Artemis-98/goldon/docs/schematic.html

# شماتیک دقیق اتصالات — برد حیاط

ESP32-S3-N8R2 · SIM800L EVB · ULN2003AN · ۲× رله · ۲× پمپ ۳V · سنسورها

منبع حقیقت: جدول اتصالات پروژه — نه خروجی حدسی AI · نسخه ۱.۰

## فهرست شیت‌ها

۰) نت‌لیست کامل (مرجع اصلی) ۱) شماتیک تغذیه ۲) شماتیک SIM800L + UART ۳) اتصالات کامل سنسورها ۴) اتصالات کامل ULN2003 + رله + پمپ ۵) نقشه GPIO استفاده شده

## ۰) نت‌لیست کامل — مرجع اصلی

هر ردیف = یک شبکه الکتریکی مشترک. هر چیزی که روی یک نت است به هم وصل است.

### باس‌های تغذیه

نام نت | اعضا (همه به هم وصل) | توضیح
+5V_BANK | خروجی + پاوربانک · ESP32 پین 5V (ورودی USB/برق برد) · SIM800L 5VIN · خازن ۱۰۰۰µF + · ULN2003 ۹ COM · رله۱ VCC · رله۲ VCC | ۵V تغذیه کنترل و کویل رله و SIM
GND | − پاوربانک · همه GNDهای ESP32 · SIM800L هر دو GND · خازن − · ULN ۸ · رله۱ GND · رله۲ GND · همه سنسورها GND · VDD منطق SIM به همین زمین برمی‌گردد | GND زمین مشترک کنترل
+3V3 | ESP32 3V3 · SIM800L VDD · خاک۱ VCC · خاک۲ VCC · DHT11 VCC · AP3216 VCC · سطح‌آب + | ۳٫۳V فقط منطق/سنسور — نه کویل رله
+3V_PUMP | خروجی + منبع ۳V جدا · COM رله۱ · COM رله۲ | ۳V فقط سمت پمپ
GND_PUMP | − منبع ۳V · − پمپ۱ · − پمپ۲ | ۳V GND می‌تواند از GND کنترل جدا بماند

### سیگنال‌ها

نام نت | از | به | جهت
SIM_TX | SIM800L TXD | ESP32 GPIO16 (RX UART1) | SIM → ESP
SIM_RX | ESP32 GPIO17 (TX UART1) | SIM800L RXD | ESP → SIM
SIM_RST | ESP32 GPIO18 | SIM800L RST | ESP → SIM
SOIL1_AO | خاک۱ AO | ESP32 GPIO1 | آنالوگ
SOIL2_AO | خاک۲ AO | ESP32 GPIO2 | آنالوگ
DHT_DATA | DHT11 DATA | ESP32 GPIO4 | ۱-سیم
I2C_SDA | AP3216 SDA | ESP32 GPIO5 | I2C
I2C_SCL | AP3216 SCL | ESP32 GPIO9 | I2C
WATER_S | سطح‌آب S | ESP32 GPIO7 | دیجیتال
RLY1_IN_B | ESP32 GPIO10 | ULN2003 ۱ (1B) | ESP → ULN
RLY2_IN_B | ESP32 GPIO11 | ULN2003 ۲ (2B) | ESP → ULN
RLY1_IN | ULN2003 ۱۶ (1C) | رله۱ IN | ULN → رله (open-collector / sink)
RLY2_IN | ULN2003 ۱۵ (2C) | رله۲ IN | ULN → رله
PUMP1+ | رله۱ NO | پمپ۱ + | سوییچ‌شده از +3V_PUMP
PUMP2+ | رله۲ NO | پمپ۲ + | سوییچ‌شده از +3V_PUMP

قواعد قطعی:

- UART متقاطع است: TXD سیم به RX برد، RXD سیم به TX برد.
- IN رله هرگز مستقیم به GPIO وصل نمی‌شود؛ فقط از خروجی C روی ULN.
- خازن ۱۰۰۰µF موازی روی نت‌های +5V_BANK و GND نزدیک SIM است، نه سری.
- پین‌های استفاده‌نشده ULN (۳–۷ و ۱۰–۱۴) باز می‌مانند.

## ۱) شماتیک تغذیه

## ۲) شماتیک SIM800L + UART

## ۳) اتصالات کامل سنسورها

همه سنسورها از ۳٫۳V ESP تغذیه می‌شوند — نه از ۵V. GND همه مشترک با ESP است.

۳٫۳V مشترک

ESP 3V3 → VCC همه سنسورها · VDD سیم‌کارت منطق SIM جداست ولی همین ۳٫۳V

GND مشترک

ESP GND → GND همه سنسورها

### ۱) رطوبت خاک ۱ — HW-103 (گیاه ۱)

پین سنسور | وصل به | رنگ | توضیح
VCC | ESP 3.3V | آبی روشن | نه ۵V
GND | ESP GND | مشکی
AO | ESP GPIO 1 | نارنجی | مقدار آنالوگ
DO | — | — | وصل نکن

### ۲) رطوبت خاک ۲ — HW-103 (گیاه ۲)

پین سنسور | وصل به | رنگ | توضیح
VCC | ESP 3.3V | آبی روشن | نه ۵V
GND | ESP GND | مشکی
AO | ESP GPIO 2 | نارنجی | مقدار آنالوگ
DO | — | — | وصل نکن

### ۳) دما / رطوبت هوا — DHT11

پین سنسور | وصل به | رنگ | توضیح
VCC (+) | ESP 3.3V | آبی روشن | نه ۵V
GND (−) | ESP GND | مشکی
DATA (وسط / S) | ESP GPIO 4 | نارنجی | سیگنال ۱-سیم

### ۴) نور محیط — AP3216 (I2C)

پین سنسور | وصل به | رنگ | توضیح
VCC | ESP 3.3V | آبی روشن | نه ۵V
GND | ESP GND | مشکی
SDA | ESP GPIO 5 | آبی | I2C Data
SCL | ESP GPIO 9 | بنفش | I2C Clock

### ۵) سنسور سطح آب (۳ پین)

پین سنسور | وصل به | رنگ | توضیح
+ (VCC) | ESP 3.3V | آبی روشن | نه ۵V
− (GND) | ESP GND | مشکی
S (Signal) | ESP GPIO 7 | نارنجی | معمولاً HIGH = آب هست

### جدول خلاصه GPIO سنسورها

GPIO | سنسور | پین ماژول | نوع
1 | خاک ۱ | AO | آنالوگ
2 | خاک ۲ | AO | آنالوگ
4 | DHT11 | DATA | دیجیتال
5 | AP3216 | SDA | I2C
9 | AP3216 | SCL | I2C
7 | سطح آب | S | دیجیتال
3V3 | همه | VCC / + | تغذیه
GND | همه | GND / − | زمین

ترتیب وصل پیشنهادی:

- اول ۳٫۳V و GND مشترک را برای همه سنسورها بکش.
- بعد سیگنال‌ها: خاک۱→GPIO1 ، خاک۲→GPIO2 ، DHT→GPIO4 ، سطح آب→GPIO7.
- در آخر AP3216: SDA→GPIO5 ، SCL→GPIO9.
- پروب خاک (میله‌ها) را در خاک بگذار؛ ماژول الکترونیک بیرون بماند.
- وقتی وصل شد بگو تا فریمور تست سنسورها را روی برد بریزم.

## ۴) اتصالات کامل ULN2003 + رله + پمپ

رله را مستقیم به GPIO نزن. مسیر درست: ESP32 → ULN2003 → IN رله → پمپ ۳V. دیود flyback جدا لازم نیست؛ با وصل پین ۹ ULN به ۵V، دیودهای داخلی فعال می‌شوند.

### دو منبع برق

منبع ۵ ولت (پاوربانک)

+ ← VCC هر دو رله · پین ۹ ULN
− ← GND مشترک با ESP و ULN و رله

منبع ۳ ولت (جدا)

+ ← فقط COM هر دو رله
− ← فقط − هر دو پمپ · مستقیم به ESP وصل نشود

### ۱) ULN2003AN

ناچ (فرورفتگی) بالا باشد. پین ۱ سمت چپ بالاست.

پین ULN | نام | وصل به | رنگ
۱ | 1B | ESP32 GPIO 10 | نارنجی
۲ | 2B | ESP32 GPIO 11 | نارنجی
۸ | GND | GND مشترک | مشکی
۹ | COM | ۵V پاوربانک | قرمز · الزامی
۱۶ | 1C | IN رله ۱ | نارنجی
۱۵ | 2C | IN رله ۲ | نارنجی

پین‌های ۳ تا ۷ و ۱۰ تا ۱۴ را وصل نکن (باز بمانند).

### ۲) رله ۱ (پمپ گیاه ۱)

پین رله | وصل به | توضیح
VCC | ۵V پاوربانک | کویل رله
GND | GND مشترک | زمین کنترل
IN | ULN پین ۱۶ (1C) | نه مستقیم از ESP
COM (ترمینال بزرگ) | + منبع ۳V | ورودی برق پمپ
NO (ترمینال بزرگ) | + پمپ ۱ | خروجی وقتی رله روشن است

### ۳) رله ۲ (پمپ گیاه ۲)

پین رله | وصل به | توضیح
VCC | ۵V پاوربانک | کویل رله
GND | GND مشترک | زمین کنترل
IN | ULN پین ۱۵ (2C) | نه مستقیم از ESP
COM | + منبع ۳V | ورودی برق پمپ
NO | + پمپ ۲ | خروجی وقتی رله روشن است

### ۴) پمپ‌ها

پمپ | پایه + | پایه −
پمپ ۱ | NO رله ۱ | − منبع ۳V
پمپ ۲ | NO رله ۲ | − منبع ۳V

### مسیر سیگنال

GPIO10 → ULN 1B → ULN 1C → IN رله۱ → (COM/NO) → پمپ۱
GPIO11 → ULN 2B → ULN 2C → IN رله۲ → (COM/NO) → پمپ۲

منطق: digitalWrite(10, HIGH) = پمپ ۱ روشن · LOW = خاموش · GPIO 11 برای پمپ ۲.

### جدول خلاصه همه اتصالات این بخش

از | به | رنگ | توضیح
GPIO 10 | ULN پین ۱ (1B) | نارنجی | سیگنال رله ۱
GPIO 11 | ULN پین ۲ (2B) | نارنجی | سیگنال رله ۲
ULN پین ۸ | GND مشترک | مشکی | زمین کنترل
ULN پین ۹ | ۵V پاوربانک | قرمز | دیودهای داخلی ULN
ULN پین ۱۶ | IN رله ۱ | نارنجی | خروجی کانال ۱
ULN پین ۱۵ | IN رله ۲ | نارنجی | خروجی کانال ۲
VCC هر رله | ۵V پاوربانک | قرمز | کویل رله
GND هر رله | GND مشترک | مشکی | زمین کنترل
+ منبع ۳V | COM هر رله | قرمز | برق پمپ
NO هر رله | + پمپ مربوط | سبز | سوییچ پمپ
− پمپ | − منبع ۳V | مشکی | برگشت پمپ

ترتیب وصل پیشنهادی:

- اول ULN به ESP (GPIO10/11 + GND + پین ۹ به ۵V).
- بعد دو رله: VCC و GND و IN از ULN.
- اول بدون پمپ تست کن (فقط صدای کلیک رله).
- در آخر منبع ۳V و پمپ‌ها را وصل کن.
- GND کنترل (ESP و ULN و رله) مشترک باشد؛ مسیر ۳V پمپ می‌تواند جدا بماند.

## ۵) نقشه GPIO استفاده شده (ESP32-S3)

GPIO | نت | ماژول | نوع
1 | SOIL1_AO | خاک ۱ AO | ADC ورودی
2 | SOIL2_AO | خاک ۲ AO | ADC ورودی
4 | DHT_DATA | DHT11 | دیجیتال ۱-سیم
5 | I2C_SDA | AP3216 | I2C
9 | I2C_SCL | AP3216 | I2C
10 | RLY1_IN_B | ULN 1B | خروجی
11 | RLY2_IN_B | ULN 2B | خروجی
7 | WATER_S | سطح آب | ورودی
16 | SIM_TX | SIM TXD | UART RX
17 | SIM_RX | SIM RXD | UART TX
18 | SIM_RST | SIM RST | خروجی

این شماتیک از روی جدول اتصالات تأییدشدهٔ پروژه نوشته شده. برای ساخت PCB در KiCad/Flux، همین نت‌لیست بخش ۰ را وارد کن — نه شماتیک حدسی AI.

گلدون هوشمند · schematic v1.0 · docs/schematic.html
