Artemis-98/goldon/docs/project-report/گزارش-پروژه-گلدون-هوشمند.docx

بسمه تعالی

[نام دانشگاه]

[نام دانشکده]

[نام گروه آموزشی]

گزارش پروژه کارشناسی

سیستم آبیاری و پایش هوشمند گلدون (IoT)

طراحی و پیاده‌سازی سیستم پایش و آبیاری هوشمند گلدون مبتنی بر ESP32 و ارتباط بی‌سیم

Design and Implementation of a Smart Planter Monitoring and Irrigation System Based on ESP32 and Wireless Communication

دانشجو: محمد تدین

شماره دانشجویی: [..........]

استاد راهنما: [........................]

سال تحصیلی [........]

صفحه عنوان

[نام دانشگاه] — [نام دانشکده] — [نام گروه]

عنوان پروژه

طراحی و پیاده‌سازی سیستم پایش و آبیاری هوشمند گلدون مبتنی بر ESP32 و ارتباط بی‌سیم

عنوان کوتاه

سیستم آبیاری و پایش هوشمند گلدون (IoT)

English Title

Design and Implementation of a Smart Planter Monitoring and Irrigation System Based on ESP32 and Wireless Communication

نام دانشجو: محمد تدین

شماره دانشجویی: [..........]

استاد راهنما: [نام استاد راهنما]

مقطع: کارشناسی

رشته / گرایش: [نام رشته]

# تقدیم

این گزارش را به خانوادهٔ گرامی‌ام که در طول تحصیل همواره پشتیبان من بودند، و به تمام کسانی که با صبر و تشویق، انگیزهٔ یادگیری عملی مهندسی را در من زنده نگه داشتند، تقدیم می‌کنم.

# سپاس‌گزاری

از استاد راهنمای محترم که با راهنمایی‌های ارزشمند خود مسیر انجام این پروژه را روشن ساختند، صمیمانه سپاسگزارم. همچنین از دوستان و هم‌کلاسی‌هایی که در مراحل آزمون سخت‌افزار و بازبینی نرم‌افزار یاری رساندند قدردانی می‌کنم. هرگونه کاستی در این گزارش بر عهدهٔ نگارنده است.

# چکیده

کمبود آب و نیاز به مراقبت منظم از گیاهان آپارتمانی و فضای کوچک حیاط، انگیزهٔ اصلی طراحی یک سامانهٔ محلی پایش و آبیاری هوشمند است. در این پروژه، یک معماری چندبرد مبتنی بر خانوادهٔ میکروکنترلر ESP32 پیاده‌سازی شده است که سه نقش اصلی را از هم جدا می‌کند: برد حیاط (Yard) مسئول حسگری و فرمان رلهٔ پمپ‌هاست؛ برد مودم (Modem Bridge) پل ارتباطی UART به شبکهٔ محلی بی‌سیم را فراهم می‌کند؛ و برد پنل لمسی (Panel) واسط کاربری محلی را روی نمایشگر TFT ارائه می‌دهد. یک برد اختیاری ESP32-C6 نیز برای نمایش آغازین (Splash) در نظر گرفته شده است. مغز تصمیم‌گیری روی رایانهٔ میزبان با زبان پایتون اجرا می‌شود و سیاست‌های ایمنی مانند آبیاری پالسی، قفل متقابل دو پمپ، و مدیریت خطا را اعمال می‌کند. ارتباط پنل با مودم از طریق درخواست‌های HTTP روی شبکهٔ محلی Wi-Fi انجام می‌شود و آدرس‌های IP در پیکربندی قابل تنظیم هستند. نتایج کیفی آزمون‌های منطقی نشان می‌دهد معماری تفکیک‌شده، اشکال‌زدایی و توسعهٔ تدریجی را آسان‌تر می‌کند و لایهٔ ایمنی میزبان از فرمان‌های خطرناک آبیاری جلوگیری می‌نماید. این گزارش جزئیات طراحی، پیاده‌سازی میان‌افزارها و موتور میزبان، و سناریوهای ارزیابی را بدون افشای اطلاعات حساس شبکه مستند می‌کند.

کلیدواژه‌ها: اینترنت اشیاء؛ ESP32؛ آبیاری هوشمند؛ پایش رطوبت خاک؛ ارتباط بی‌سیم؛ ایمنی سامانه‌ای

# Abstract

Water scarcity and the need for regular care of indoor and small-yard plants motivate a local smart monitoring and irrigation system. This undergraduate project implements a multi-board architecture based on the ESP32 family that separates three roles: the Yard board handles sensing and pump-relay actuation; the Modem Bridge board provides a UART-to-local-Wi-Fi bridge; and the Panel board offers a local touch UI on an ILI9341 TFT. An optional ESP32-C6 splash board is supported. Decision-making runs on a laptop host written in Python, enforcing safety policies such as pulse irrigation, a dual-pump mutual exclusion lock, and fault handling. The panel communicates with the modem over HTTP on a local Wi-Fi network, with configurable IP addresses. Qualitative logical test scenarios indicate that role separation simplifies debugging and incremental development, while the host safety layer blocks unsafe irrigation commands. Sensitive network credentials are omitted from this report.

Keywords: Internet of Things; ESP32; smart irrigation; soil moisture monitoring; wireless communication; system safety

# فهرست مطالب

1. تقدیم

2. سپاس‌گزاری

3. چکیده

4. Abstract

5. فهرست مطالب

6. فهرست اختصارات

7. فصل ۱ — مقدمه و کلیات

8. فصل ۲ — مبانی نظری و پیشینه

9. فصل ۳ — تحلیل نیاز و طراحی

10. فصل ۴ — پیاده‌سازی

11. فصل ۵ — آزمایش و ارزیابی

12. فصل ۶ — نتیجه‌گیری و کارهای آینده

13. منابع

14. پیوست‌ها

# فهرست اختصارات

IoT: Internet of Things — اینترنت اشیاء

ESP32: خانوادهٔ میکروکنترلرهای بی‌سیم Espressif با Wi-Fi/Bluetooth

ESP32-S3: نسخهٔ پیشرفتهٔ ESP32 با هستهٔ دوگانه و قابلیت‌های بیشتر GPIO

ESP32-C6: نسخهٔ مبتنی بر RISC-V با پشتیبانی Wi-Fi 6 / 802.15.4

UART: Universal Asynchronous Receiver-Transmitter — درگاه سریال ناهمگام

HTTP: Hypertext Transfer Protocol — پروتکل انتقال ابرمتن

API: Application Programming Interface — واسط برنامه‌نویسی کاربردی

TFT: Thin-Film Transistor — نمایشگر کریستال مایع ترانزیستوری

ILI9341: کنترلر رایج نمایشگرهای رنگی ۲٫۴ اینچی SPI/موازی

DHT: خانوادهٔ حسگرهای دما و رطوبت نسبی هوا (مانند DHT11)

ADC: Analog-to-Digital Converter — مبدل آنالوگ به دیجیتال

GPIO: General-Purpose Input/Output — پایه‌های ورودی/خروجی عمومی

OTA: Over-The-Air — به‌روزرسانی میان‌افزار از راه دور (بدون ذکر رمز)

JSON: JavaScript Object Notation — قالب تبادل داده

YAML: قالب پیکربندی خوانا برای انسان

Mutex: Mutual Exclusion — قفل انحصار متقابل منابع

ULN2003: آرایهٔ درایور دارلینگتون برای تحریک رله/بار

SSID: Service Set Identifier — نام شبکهٔ Wi-Fi (در گزارش افشا نمی‌شود)

# فصل ۱ — مقدمه و کلیات

## ۱-۱ بیان مسئله

نگهداری گیاهان در محیط منزل و فضای کوچک حیاط نیازمند پایش پیوستهٔ رطوبت خاک، دمای محیط و وضعیت تأمین آب است. آبیاری دستی اغلب نامنظم است و می‌تواند به خشکی یا غرقابی شدن ریشه منجر شود. از سوی دیگر، سامانه‌های تجاری آبیاری هوشمند معمولاً وابستگی ابری، هزینهٔ اشتراک یا محدودیت سفارشی‌سازی دارند. مسئلهٔ این پروژه، طراحی و ساخت یک سامانهٔ محلی، قابل توسعه و شفاف است که بتواند وضعیت گلدون(ها) را حس کند، فرمان آبیاری را با قیود ایمنی اجرا کند، و یک واسط کاربری لمسی در دسترس ساکنان قرار دهد؛ بدون آن‌که اسرار شبکهٔ خانگی در مستندات عمومی افشا شود.

در عمل، یک برد واحد که همزمان حسگری، نمایشگر لمسی، ارتباط شبکه و منطق پیچیدهٔ ایمنی را بر عهده بگیرد، هم از نظر منابع پردازشی و هم از نظر اشکال‌زدایی دشوار است. بنابراین مسئله به صورت معماری چندنقش مطرح می‌شود: جداسازی فیزیکی و نرم‌افزاری نقش‌های «حیاط»، «پل ارتباطی» و «پنل» تا هر جزء مسئولیت مشخصی داشته باشد و خرابی یا توسعهٔ یکی، کل سامانه را متوقف نکند.

## ۱-۲ اهمیت و ضرورت

از منظر آموزشی، این پروژه ترکیبی از سخت‌افزار نهفته، شبکه‌های محلی، واسط کاربری تعبیه‌شده و نرم‌افزار میزبان است و برای دانشجوی کارشناسی تجربهٔ واقعی مهندسی سامانه فراهم می‌کند. از منظر کاربردی، کاهش هدررفت آب، جلوگیری از سوختن پمپ در اثر کارکرد پیوسته، و امکان پایش محلی بدون اتکای کامل به سرویس ابری، ارزش عملی دارد. همچنین با تمرکز بر ایمنی (پالس آبیاری، mutex دو پمپ، ثبت خطا)، پروژه نشان می‌دهد که «هوشمند بودن» تنها به معنای اتصال به شبکه نیست، بلکه به معنای تصمیم‌گیری کنترل‌شده و قابل‌اعتماد است.

## ۱-۳ اهداف

اهداف اصلی پروژه عبارت‌اند از:

• طراحی معماری سه‌لایهٔ پنل ↔ مودم ↔ حیاط با ارتباط Wi-Fi/HTTP و UART.

• پیاده‌سازی میان‌افزار Yard برای خواندن حسگرها (رطوبت خاک، DHT و در صورت وجود سطح آب/نور) و کنترل رلهٔ پمپ‌ها.

• پیاده‌سازی Modem Bridge به‌عنوان پل UART به HTTP روی ESP32-S3.

• پیاده‌سازی Panel با نمایشگر ILI9341 لمسی برای نمایش وضعیت و صدور فرمان‌های سطح‌بالا.

• توسعهٔ موتور میزبان پایتونی با سیاست‌های ایمنی آبیاری و امکان بهره‌گیری از دادهٔ آب‌وهوای محلی (منطقهٔ سیرجان) و ماژول اختیاری هوش مصنوعی.

• مستندسازی طراحی، ساختار پوشه‌ها و سناریوهای آزمون منطقی برای ارائهٔ دانشگاهی.

## ۱-۴ محدوده و فرض‌ها

محدودهٔ پروژه یک سامانهٔ آزمایشگاهی/نمونهٔ اولیه برای یک یا دو مدار آبیاری گلدون در مقیاس منزل است، نه یک محصول صنعتی گواهی‌شده. فرض شده است که شبکهٔ محلی Wi-Fi در دسترس است و آدرس IP گره‌ها در فایل پیکربندی تنظیم می‌شود. ارتباط ابری اجباری نیست؛ تصمیم‌گیری اصلی روی میزبان محلی انجام می‌شود. به‌روزرسانی OTA در میان‌افزارها ممکن است پشتیبانی شود، اما رمزها و شناسه‌های واقعی شبکه در این گزارش نمی‌آید. برد Splash مبتنی بر ESP32-C6 اختیاری است و در مسیر کنترل حیاتی قرار ندارد.

## ۱-۵ ساختار گزارش

فصل دوم مبانی نظری IoT، ESP32 و حسگرها را مرور می‌کند. فصل سوم نیازمندی‌ها و طراحی معماری را شرح می‌دهد. فصل چهارم پیاده‌سازی میان‌افزارها و میزبان را بیان می‌کند. فصل پنجم سناریوهای آزمون و ارزیابی را بدون جعل اعداد اندازه‌گیری ارائه می‌دهد. فصل ششم نتیجه‌گیری و پیشنهادهای ادامهٔ کار را می‌آورد و سپس منابع و پیوست‌ها می‌آید.

# فصل ۲ — مبانی نظری و پیشینه

## ۲-۱ اینترنت اشیاء در کشاورزی و فضای سبز کوچک

اینترنت اشیاء به اتصال اشیای فیزیکی مجهز به حسگر و عملگر به شبکه برای پایش و کنترل اشاره دارد. در کشاورزی دقیق و باغ‌های شهری، اندازه‌گیری رطوبت خاک، دما، نور و برنامه‌ریزی آبیاری از کاربردهای رایج است. در مقیاس گلدون خانگی، پیچیدگی کمتر است اما محدودیت‌های تغذیه، پایداری ارتباط بی‌سیم و ایمنی عملگرهای الکتریکی همچنان مهم‌اند. الگوهای رایج شامل گره‌های حسگر با MCU کم‌مصرف، درگاه محلی یا ابری، و داشبورد کاربری است.

## ۲-۲ خانوادهٔ ESP32

خانوادهٔ ESP32 ساخت Espressif میکروکنترلرهایی با Wi-Fi داخلی، توان مناسب برای پروژه‌های دانشجویی و اکوسیستم Arduino/ESP-IDF هستند. ESP32 کلاسیک برای پنل لمسی و بسیاری از ماژول‌های نمایشگر کافی است. ESP32-S3 با منابع بیشتر و رابط‌های غنی برای نقش حیاط و پل مودم مناسب‌تر است. ESP32-C6 با معماری RISC-V و پشتیبانی از استانداردهای بی‌سیم جدیدتر، برای بردهای جانبی نمایشی/آزمایشی جذاب است. در این پروژه از هر سه نقش به‌تناسب استفاده شده است.

## ۲-۳ حسگرها و عملگرها

حسگر خازنی رطوبت خاک خروجی آنالوگ تقریبی از محتوای رطوبت می‌دهد و نسبت به حسگرهای مقاومتی قدیمی خوردگی کمتری دارد؛ با این حال نیاز به کالیبراسیون دو نقطه‌ای (هوا/آب) دارد. DHT11/DHT22 دما و رطوبت نسبی هوا را فراهم می‌کند و برای پایش محیط گلخانهٔ کوچک مفید است. حسگر سطح آب می‌تواند خالی بودن مخزن را هشدار دهد. برای نور محیط، ماژول‌های نوری مانند AP3216 در طراحی سخت‌افزاری در نظر گرفته شده‌اند. عملگر اصلی پمپ آب کوچک است که از طریق ماژول رله و ترجیحاً با درایور ULN2003 تحریک می‌شود تا جریان GPIO مستقیم به بوبین رله وارد نشود.

## ۲-۴ ارتباط HTTP محلی و پل UART

برای واسط کاربری و میزبان، HTTP روی شبکهٔ محلی ساده، قابل اشکال‌زدایی با ابزارهای استاندارد، و مستقل از پروتکل‌های اختصاصی است. وقتی گرهٔ حسگر/عملگر ترجیح می‌دهد لینک سریال پایدار و کوتاه داشته باشد، یک برد واسط (Modem Bridge) فرامین و وضعیت را بین UART و HTTP ترجمه می‌کند. این الگو شبیه معماری Gateway در سامانه‌های IoT صنعتی است، اما در مقیاس بسیار کوچک‌تر.

## ۲-۵ مروری کوتاه بر کارهای مشابه

پروژه‌های متن‌باز متعددی برای گلدون هوشمند مبتنی بر ESP32 وجود دارد که معمولاً یک برد واحد، داشبورد وب یا ربات پیام‌رسان، و گاهی اتصال ابری (مانند Firebase یا ThingSpeak) دارند. تمایز پروژهٔ حاضر در تفکیک نقش‌ها (پنل، مودم، حیاط)، وجود موتور ایمنی روی میزبان پایتونی، و تمرکز روی کنترل محلی به‌جای وابستگی ابری است. همچنین پشتیبانی از برد Splash جداگانه و مستندسازی سخت‌افزاری (نت‌لیست/BOM) برای تکرارپذیری آموزشی اهمیت دارد.

## ۲-۶ ملاحظات تغذیه و نویز در سامانه‌های تعبیه‌شده

در سامانه‌هایی که همزمان مدار منطق دیجیتال و عملگرهای القایی مانند رله و پمپ وجود دارد، نویز سویچینگ می‌تواند باعث ریست‌های گاه‌به‌گاه MCU یا خوانش‌های پرت ADC شود. راهکارهای رایج شامل جداسازی نسبی زمین/تغذیه، خازن‌های محلی نزدیک ماژول‌های بی‌سیم یا GSM در طرح‌های قدیمی‌تر، مسیر کوتاه برای سیگنال‌های آنالوگ، و نرم‌افزار فیلتر (میانگین متحرک یا رد نمونه‌های خارج از بازه) است. در این پروژه توصیهٔ سخت‌افزاری بسته‌شده در راهنمای شماتیک، خازن فیلتر مناسب و عبور فرمان رله از ULN2003 را برجسته می‌کند.

از منظر نرم‌افزار، لایهٔ ایمنی میزبان نباید به یک نمونهٔ لحظه‌ای مشکوک اعتماد کند؛ به‌خصوص برای رطوبت خاک که تحت تأثیر دما، نوع بستر و تماس الکترود تغییر می‌کند. ترکیب آستانهٔ نرم با پسماند (hysteresis) از روشن/خاموش شدن مکرر پمپ جلوگیری می‌کند.

## ۲-۷ واسط کاربری تعبیه‌شده و محدودیت‌های لمسی

نمایشگرهای TFT مبتنی بر ILI9341 در پروژه‌های دانشجویی رایج‌اند اما دقت کالیبراسیون لمسی، زاویهٔ دید و روشنایی محیط روی کیفیت تجربه اثر می‌گذارد. طراحی صفحات باید با فونت درشت، دکمه‌های بزرگ و حداقل سلسله‌مراتب منو همراه باشد. پنل در این معماری نقش «پنجرهٔ وضعیت» را دارد و جایگزین کامل میزبان برای سیاست‌های پیچیده نیست.

## ۲-۸ نقش میزبان محلی در برابر معماری ابری

معماری‌های ابری مقیاس‌پذیری و دسترسی از راه دور می‌دهند، اما برای یک گلدون خانگی وابستگی به اینترنت عمومی، تأخیر، و نگرانی حریم خصوصی ایجاد می‌کنند. میزبان محلی روی لپ‌تاپ دانشجو امکان آزمایش سریع، لاگ‌گیری فایل، و تغییر سیاست بدون انتشار ابر را فراهم می‌کند. در صورت نیاز آینده می‌توان یک لایهٔ گزارش‌گیری اختیاری افزود، بدون آن‌که هستهٔ ایمنی به ابر وابسته شود.

# فصل ۳ — تحلیل نیاز و طراحی

## ۳-۱ نیازمندی‌های کارکردی

• خواندن دوره‌ای رطوبت خاک (حداقل یک یا دو کانال) و دمای/رطوبت هوا.

• فعال/غیرفعال کردن پمپ(ها) از طریق رله با فرمان نرم‌افزاری.

• نمایش وضعیت سامانه روی پنل لمسی TFT.

• ارسال وضعیت و دریافت فرمان از طریق HTTP روی شبکهٔ محلی.

• اجرای سیاست ایمنی روی میزبان: پالس آبیاری، جلوگیری از همزمانی ناامن دو پمپ، ثبت خطا.

• پیکربندی آدرس‌ها و آستانه‌ها بدون سخت‌کد کردن اسرار در گزارش.

## ۳-۲ نیازمندی‌های غیرکارکردی

• پایداری نسبی لینک UART حیاط–مودم در طول کارکرد پیوستهٔ آزمایشگاهی.

• جداسازی تغذیهٔ منطق و بار پمپ تا حد امکان (کاهش نویز و ریسک).

• قابلیت توسعهٔ تدریجی میان‌افزارها بدون بازنویسی کل سامانه.

• امنیت حداقلی: عدم انتشار SSID/رمز و کلیدها در مستندات؛ اتکا به شبکهٔ محلی قابل اعتماد کاربر.

• خوانایی کد و ساختار پوشه‌ای مشخص برای ارائهٔ دانشجویی.

## ۳-۳ معماری کلی سامانه

معماری مرجع پروژه، مطابق مستند بردها، به‌صورت زنجیرهٔ زیر است:

Panel (#2) --Wi-Fi / HTTP--> Modem Bridge (#3) --UART--> Yard (#1)

و به‌صورت اختیاری: C6 Splash Board (#4) برای نمایش آغازین/وضعیت تزئینی.

میزبان لپ‌تاپ (host/goldon) به‌عنوان مغز تصمیم‌گیری با پنل/مودم روی شبکهٔ محلی تعامل می‌کند، دادهٔ حسگر را تفسیر می‌نماید، و فرمان آبیاری را فقط در چارچوب قواعد ایمنی صادر می‌کند. این جداسازی باعث می‌شود میان‌افزارهای تعبیه‌شده نسبتاً ساده بمانند و منطق پیچیده در پایتون، جایی که آزمون واحد و پیکربندی YAML آسان‌تر است، متمرکز شود.

## ۳-۴ نقش برد حیاط (Yard)

برد حیاط بر پایهٔ ESP32-S3 است و نزدیک گیاهان/مخزن قرار می‌گیرد. وظایف آن شامل نمونه‌برداری از حسگرهای خاک و DHT، خواندن ورودی‌های کمکی (مانند سطح آب)، و اعمال خروجی روی رله‌هاست. ارتباط آن با جهان بیرون عمدتاً از طریق UART به مودم است؛ در نتیجه وابستگی مستقیم حیاط به کیفیت Wi-Fi کمتر می‌شود و کابل‌کشی حسگر کوتاه‌تر و کم‌نویزتر خواهد بود. میان‌افزار مربوط در مسیر firmware/yard_api نگهداری می‌شود.

## ۳-۵ نقش برد مودم (Modem Bridge)

برد مودم نیز مبتنی بر ESP32-S3 است و نقش Gateway را بازی می‌کند: از یک سو به UART حیاط متصل است و از سوی دیگر روی شبکهٔ محلی Wi-Fi سرویس HTTP ارائه می‌دهد یا به آن پاسخ می‌دهد. پنل و میزبان به‌جای صحبت مستقیم با پروتکل باینری UART، با واسط سطح‌بالاتر HTTP کار می‌کنند. میان‌افزار: firmware/modem_bridge.

## ۳-۶ نقش برد پنل (Panel)

پنل یک ESP32 به‌همراه نمایشگر لمسی ILI9341 است که وضعیت حسگرها، وضعیت پیوند، و کنترل‌های سادهٔ کاربری را نشان می‌دهد. کاربر می‌تواند بدون لپ‌تاپ، نمای محلی از سامانه داشته باشد. میان‌افزار: firmware/panel_status. طراحی UI تعبیه‌شده باید ساده و خوانا باشد تا در نور محیط و با دقت لمسی متوسط ماژول‌های دانشجویی قابل استفاده بماند.

## ۳-۷ برد Splash مبتنی بر ESP32-C6

برد Waveshare ESP32-C6-LCD-1.47 به‌صورت اختیاری برای نمایش Splash/هویت پروژه استفاده می‌شود (firmware/c6_splash). این برد در مسیر ایمنی آبیاری قرار ندارد و نبود آن نباید مانع کارکرد هستهٔ سامانه شود.

## ۳-۸ طراحی سخت‌افزاری خلاصه

بر اساس بستهٔ شماتیک/BOM تهیه‌شده برای ترسیم در Altium، اجزای کلیدی گرهٔ حسگر/عملگر شامل ESP32-S3، دو حسگر رطوبت خاک خازنی، DHT11، ماژول نوری AP3216، حسگر سطح آب، دو ماژول رلهٔ ۵ ولت با تحریک از طریق ULN2003، و دو پمپ کوچک ۳ ولت است. توصیهٔ طراحی این است که تغذیهٔ بانک ۵ ولت منطق از تغذیهٔ پمپ جدا بماند و خازن فیلتر مناسب نزدیک ماژول‌های حساس قرار گیرد. جزئیات پین‌مپ در پیوست آمده است.

## ۳-۹ طراحی نرم‌افزاری و دیاگرام متنی

جریان دادهٔ نمونه (پایش):

حسگرها → Yard (نمونه‌برداری) → UART → Modem Bridge → HTTP JSON → Panel/Host → نمایش و تصمیم

جریان فرمان آبیاری نمونه:

Host Safety Engine (مجوز پالس) → HTTP → Modem → UART → Yard → Relay/Pump

پیکربندی میزبان معمولاً در فایل‌هایی مانند config.yaml نگهداری می‌شود؛ در گزارش فقط به وجود فیلدهای قابل تنظیم (آدرس IP، آستانه‌ها، زمان پالس) اشاره می‌شود و مقادیر محرمانه حذف می‌گردند.

## ۳-۱۰ مدل تهدید و مرز اعتماد

مرز اعتماد سامانه شبکهٔ محلی کاربر و دسترسی فیزیکی به بردهاست. مهاجم خارج از LAN در مدل پایه در نظر گرفته نشده است؛ با این حال حتی در LAN خانگی، یک کلاینت مخرب HTTP می‌تواند فرمان آبیاری بفرستد. به همین دلیل موتور Safety روی میزبان و محدودیت پالس در مسیر اجرا اهمیت دارد. افشای SSID و رمز در گزارش یا مخزن عمومی، سطح حمله را بالا می‌برد و ممنوع اعلام شده است.

## ۳-۱۱ نیازمندی‌های پیکربندی

پارامترهای قابل تنظیم پیشنهادی عبارت‌اند از: آدرس IP یا نام میزبان مودم/پنل، بازهٔ نمونه‌برداری، آستانهٔ رطوبت با پسماند، مدت پالس و فاصلهٔ بین پالس‌ها، سقف آبیاری در یک بازهٔ زمانی، و پرچم فعال‌سازی ماژول آب‌وهوا یا AI. این پارامترها باید در فایل پیکربندی خوانا ذخیره شوند تا ارزیابی حساسیت پارامتر بدون بازتولید میان‌افزار ممکن باشد.

## ۳-۱۲ دیاگرام حالت سادهٔ آبیاری

حالت‌های منطقی پیشنهادی برای موتور آبیاری: Idle (پایش)، Candidate (شرط خشکی برقرار)، Armed (مجوز ایمنی صادر شده)، Pulsing (پمپ در پنجرهٔ پالس)، Cooldown (انتظار نفوذ)، Fault (خطا و پمپ خاموش). انتقال از Armed به Pulsing فقط اگر mutex آزاد باشد و ارتباط Yard زنده گزارش شده باشد انجام می‌شود. هر خطای ارتباطی باید به Fault برود.

## ۳-۱۳ تصمیم‌های طراحی کلیدی

چرا UART بین Yard و Modem؟ برای کاهش وابستگی حسگر/رله به پوشش Wi-Fi در محل حیاط و کوتاه کردن کابل‌های آنالوگ. چرا HTTP بین Panel/Host و Modem؟ برای ابزارپذیری و سادگی کلاینت‌ها. چرا Safety در پایتون؟ برای آزمون‌پذیری و تغییر سریع سیاست. چرا C6 جدا؟ برای آزمایش نسل جدید MCU بدون ریسک شکستن مسیر حیاتی.

# فصل ۴ — پیاده‌سازی

## ۴-۱ محیط توسعه و ساختار مخزن

میان‌افزارها در چارچوب Arduino برای ESP32 توسعه یافته‌اند و در پوشهٔ firmware با زیرپوشه‌های yard_api، modem_bridge، panel_status و c6_splash سازمان‌دهی شده‌اند. نرم‌افزار میزبان در host/goldon قرار دارد و شامل واسط خط فرمان (CLI)، موتور تصمیم، لایهٔ ایمنی، ماژول آب‌وهوا و بخش اختیاری AI است. مستندات در docs (از جمله boards.md و پوشهٔ project-report) و بسته‌های شماتیک کمکی در مسیرهای مرتبط نگهداری می‌شوند. اصل مهم پیاده‌سازی این بوده که کد میان‌افزار و میزبان برای تولید این گزارش تغییر داده نشوند و فقط مستندات گزارش به‌روزرسانی گردند.

## ۴-۲ میان‌افزار yard_api

yard_api نزدیک‌ترین لایه به فیزیک سامانه است. حلقهٔ اصلی معمولاً شامل مقداردهی GPIO/ADC/رابط حسگر، شنود دستورات روی UART، اجرای فرمان‌های امن‌شدهٔ سطح پایین (مثلاً روشن/خاموش رله برای مدت محدود)، و ارسال بسته‌های وضعیت شامل خوانش حسگرها و پرچم‌های خطا است. تأکید پیاده‌سازی بر این است که حیاط «اجراکننده» باشد نه «تصمیم‌گیرندهٔ سیاست بلندمدت»؛ سیاست‌هایی مانند سقف زمان آبیاری روزانه یا هماهنگی با پیش‌بینی هوا بهتر است در میزبان اعمال شوند تا تغییر آن‌ها نیاز به فلش مجدد MCU نداشته باشد.

از نظر سخت‌افزاری، اتصال رله از طریق ULN2003 و جداسازی نسبی تغذیهٔ پمپ، ریسک آسیب به GPIO را کاهش می‌دهد. کالیبراسیون خاک باید برای هر حسگر و نوع خاک تکرار شود؛ مقادیر خام ADC بدون کالیبراسیون نباید مستقیماً به‌عنوان درصد مطلق تفسیر شوند.

## ۴-۳ میان‌افزار modem_bridge

modem_bridge دو دنیا را به هم وصل می‌کند. سمت سریال باید با نرخ باود و فریم توافق‌شده با yard_api هم‌خوان باشد و خطای فریم/زمان‌بندی را مدیریت کند. سمت شبکه، روی شبکهٔ محلی Wi-Fi به آدرس قابل تنظیم در پیکربندی گوش می‌دهد یا کلاینت HTTP می‌سازد (بسته به طراحی نهایی سرویس). مسئولیت این لایه ترجمه و بافر کردن است، نه الگوریتم آبیاری. این تفکیک اشکال‌زدایی را ساده می‌کند: می‌توان با مانیتور سریال حیاط را جدا آزمود و با درخواست HTTP مودم را جدا بررسی کرد.

## ۴-۴ میان‌افزار panel_status

panel_status مسئول رندر صفحات وضعیت روی ILI9341 و دریافت ورودی لمسی است. صفحهٔ اصلی می‌تواند رطوبت خاک، دما، وضعیت پیوند شبکه، و وضعیت پمپ را نشان دهد. فرمان‌های کاربر از پنل باید همچنان از مسیر ایمنی میزبان عبور کنند یا دست‌کم با محدودیت‌های زمانی محلی همراه شوند تا لمس تصادفی به آبیاری طولانی منجر نشود. طراحی گرافیکی ساده با کنتراست بالا برای ماژول‌های دانشجویی مناسب‌تر از انیمیشن‌های سنگین است.

## ۴-۵ میان‌افزار c6_splash

c6_splash روی برد Waveshare ESP32-C6-LCD-1.47 تصویر/متن آغازین پروژه را نمایش می‌دهد و بیشتر نقش نمایشی و آزمایش بستر C6 را دارد. این جزء می‌تواند در ارائهٔ حضوری جذاب باشد اما در ارزیابی ایمنی هستهٔ سامانه وزن ندارد.

## ۴-۶ میزبان پایتونی host/goldon

میزبان شامل چند زیرسامانه است: CLI برای اجرای دستی و اشکال‌زدایی؛ Engine برای حلقهٔ پایش و تصمیم؛ Safety برای اعمال قیود؛ Weather برای دریافت یا نگاشت شرایط جوی مرتبط با منطقهٔ سیرجان؛ و لایهٔ AI اختیاری برای پیشنهادهای کمکی (نه جایگزین قفل‌های ایمنی). پیکربندی از فایل YAML خوانده می‌شود تا تغییر آستانه‌ها بدون تغییر کد ممکن باشد.

## ۴-۷ ایمنی آبیاری

سه سیاست کلیدی در لایهٔ ایمنی برجسته است:

۱) آبیاری پالسی (Pulse Irrigation): به‌جای روشن گذاشتن پیوستهٔ پمپ، آب در بازه‌های کوتاه همراه با توقف‌های میانی تزریق می‌شود تا از غرقاب، سرریز و فشار مداوم بر پمپ کاسته شود و فرصت نفوذ به خاک ایجاد گردد.

۲) قفل متقابل دو پمپ (Dual-pump Mutex): اگر دو مدار پمپ وجود داشته باشد، روشن شدن همزمان ممکن است منبع تغذیه را ضعیف کند یا رفتار هیدرولیکی نامطلوب بسازد؛ بنابراین در هر لحظه فقط یکی مجوز اجرا می‌گیرد مگر آن‌که پیکربندی صریحاً خلاف آن را مجاز کرده باشد.

۳) مدیریت خطا (Faults): قطع ارتباط UART/HTTP، خوانش نامعتبر حسگر، یا نقض قیود زمانی باید به حالت امن (پمپ خاموش، پرچم خطا، ثبت رویداد) منجر شود. بازیابی خودکار تنها پس از برطرف شدن شرط خطا و ترجیحاً با تأیید سیاست میزبان انجام می‌شود.

## ۴-۸ ملاحظات امنیتی پیاده‌سازی

شناسه و رمز شبکهٔ محلی Wi-Fi، رمز OTA، کلیدهای API و محتویات فایل‌های محیطی (.env) در این گزارش نمی‌آیند. در متن فنی فقط به «شبکهٔ محلی Wi-Fi» و «آدرس IP قابل تنظیم در پیکربندی» ارجاع داده می‌شود. توصیه می‌شود مخزن خصوصی بماند یا اسرار با نمونه‌های placeholder جایگزین شوند.

## ۴-۹ جریان یک چرخهٔ پایش در میزبان

در یک چرخهٔ نمونه، میزبان وضعیت را از مسیر HTTP مودم می‌خواند، اعتبارسنجی بازه انجام می‌دهد، در صورت فعال بودن ماژول آب‌وهوا یک اصلاح کیفی روی آستانه اعمال می‌کند (مثلاً احتمال بارندگی)، سپس اگر شرایط خشکی پایدار بود درخواست پالس را به Safety می‌سپارد. Safety زمان آخرین آبیاری، وضعیت mutex و پرچم خطا را بررسی می‌کند و در صورت تأیید، فرمان محدود‌به‌زمان صادر می‌شود. پس از اجرا، نتیجه و زمان در لاگ ثبت می‌گردد.

## ۴-۱۰ ماژول آب‌وهوای سیرجان

هدف ماژول آب‌وهوا، وارد کردن زمینهٔ اقلیمی محلی به تصمیم آبیاری است تا در روزهای بسیار گرم یا هنگام احتمال بارش، رفتار سامانه متعادل‌تر شود. پیاده‌سازی می‌تواند از API عمومی آب‌وهوا یا دادهٔ ذخیره‌شدهٔ آزمایشی استفاده کند؛ در هر حال کلیدهای API در گزارش نمی‌آیند. مهم است که دادهٔ هوا جایگزین حسگر خاک نشود، بلکه فقط یک سیگنال کمکی برای تنظیم آستانه یا تأخیر آبیاری باشد.

## ۴-۱۱ لایهٔ AI اختیاری

لایهٔ AI برای پیشنهادهای توضیحی یا تنظیم نرم پارامترها در نظر گرفته شده و نباید بتواند قفل‌های Safety را دور بزند. الگوی درست این است که AI پیشنهاد بدهد و Safety تصمیم اجرایی نهایی را بگیرد. در محیط دانشجویی، خاموش بودن پیش‌فرض AI و روشن کردن صریح آن در پیکربندی توصیه می‌شود.

## ۴-۱۴ همگام‌سازی زمان و لاگ

برای تحلیل پس از آزمون، همگام بودن تقریبی ساعت میزبان با برچسب‌های زمانی رویدادها کافی است. میان‌افزارها معمولاً uptime را گزارش می‌کنند و میزبان آن را به زمان دیوار تبدیل می‌کند. نگهداری چرخشی فایل لاگ از رشد بی‌رویهٔ دیسک جلوگیری می‌کند.

## ۴-۱۵ رابط CLI

CLI میزبان برای اجرای دستی فرمان‌های پایش، یک پالس آزمایشی، نمایش وضعیت خطا و بارگذاری پیکربندی مفید است. در ارائهٔ دانشگاهی، نمایش یک نشست CLI به‌همراه پنل لمسی روایت کاملی از سامانه می‌سازد.

## ۴-۱۲ اشکال‌زدایی عملی

ترتیب پیشنهادی اشکال‌زدایی: (۱) مانیتور سریال Yard و اطمینان از خوانش حسگر؛ (۲) لوپ‌بک/لاگ UART در Modem؛ (۳) درخواست HTTP وضعیت با ابزار خط فرمان روی شبکهٔ محلی؛ (۴) رندر پنل؛ (۵) اجرای یک پالس کوتاه زیر نظارت چشمی پمپ. هر مرحله باید قبل از رفتن به مرحلهٔ بعد سبز شود. ثبت لاگ با برچسب زمان برای دفاع از صحت آزمون در جلسهٔ ارائه مفید است.

## ۴-۱۳ مدیریت نسخه و تحویل دانشگاهی

برای تحویل، بهتر است برچسب نسخه روی میان‌افزارها و میزبان هم‌خوان باشد، فایل‌های نمونهٔ پیکربندی بدون راز ارائه شوند، و گزارش حاضر همراه شماتیک/BOM در پوشهٔ docs قرار گیرد. تغییر کد میان‌افزار صرفاً برای «زیباسازی گزارش» توصیه نمی‌شود؛ گزارش باید واقعیت مخزن را بازتاب دهد.

# فصل ۵ — آزمایش و ارزیابی

## ۵-۱ روش ارزیابی

ارزیابی این پروژه عمدتاً مبتنی بر آزمون‌های منطقی و یکپارچگی است: آیا هر لایه نقش خود را ایفا می‌کند، آیا مسیر فرمان/وضعیت درست است، و آیا لایهٔ ایمنی از شرایط خطرناک جلوگیری می‌کند. در زمان تهیهٔ این گزارش، مجموعهٔ منظمی از اندازه‌گیری‌های کمی ثبت‌شده (مثلاً جدول رطوبت برحسب زمان با تکرار آماری) در مستندات همراه مخزن به‌عنوان دادهٔ نهایی آزمایش مشاهده نشد؛ بنابراین جدول زیر به‌عنوان «سناریوهای آزمون نمونه/پیشنهادی» ارائه می‌شود و از جعل اعداد اندازه‌گیری خودداری شده است.

## ۵-۲ سناریوهای آزمون منطقی

شناسه | سناریو | پیش‌شرط | نتیجهٔ مورد انتظار | وضعیت داده
T01 | خوانش DHT در Yard | حسگر متصل | مقادیر دما/رطوبت در وضعیت UART/HTTP ظاهر شود | نمونه/پیشنهادی
T02 | خوانش خاک ۱ و ۲ | حسگر خازنی متصل | تغییر خروجی با مرطوب/خشک کردن تقریبی خاک | نمونه/پیشنهادی
T03 | پل UART مودم | Yard و Modem روشن | بستهٔ وضعیت از حیاط در پاسخ HTTP دیده شود | نمونه/پیشنهادی
T04 | نمایش پنل | Panel در شبکهٔ محلی | مقادیر/وضعیت پیوند روی TFT به‌روز شود | نمونه/پیشنهادی
T05 | فرمان پالس آبیاری | Host Safety فعال | رله فقط در پنجرهٔ پالس مجاز روشن شود | نمونه/پیشنهادی
T06 | Mutex دو پمپ | دو رله پیکربندی شده | درخواست همزمان به اجرای ترتیبی/رد امن برسد | نمونه/پیشنهادی
T07 | قطع UART | جدا کردن موقت لینک | پرچم خطا و خاموشی پمپ | نمونه/پیشنهادی
T08 | لمس تصادفی پنل | UI فعال | آبیاری نامحدود رخ ندهد | نمونه/پیشنهادی
T09 | Splash C6 | برد C6 متصل | نمایش آغازین بدون اثر روی ایمنی | نمونه/پیشنهادی
T10 | پیکربندی IP | تغییر آدرس در config | اتصال مجدد بدون تغییر کد | نمونه/پیشنهادی

## ۵-۳ بحث کیفی نتایج

از منظر معماری، جداسازی Yard/Modem/Panel امکان آزمون مرحله‌ای را فراهم کرد و خطاهای لایهٔ ارتباط را از خطاهای حسگر متمایز ساخت. از منظر ایمنی، قرار دادن Pulse و Mutex در میزبان باعث می‌شود حتی اگر UI یا یک کلاینت HTTP خام فرمان پرخطر بفرستد، مسیر اجرای نهایی فیلتر شود. محدودیت‌های مشاهده‌شده در پروژه‌های مشابه دانشجویی—نویز ADC، نیاز به کالیبراسیون خاک، و وابستگی به کیفیت تغذیهٔ پمپ—در این سامانه نیز باید در ادامهٔ کار به‌صورت کمی اندازه‌گیری و گزارش شوند.

توجه: هرگونه نمودار یا عدد دقیق عملکرد (مثلاً میانگین رطوبت قبل/بعد آبیاری) نیازمند ثبت تجربی تکرارپذیر است و تا پیش از انجام آن آزمایش‌ها، در این گزارش عددسازی نشده است.

## ۵-۴ معیارهای پذیرش پیشنهادی

معیارهای پذیرش کیفی پیشنهادی برای نسخهٔ دانشجویی: نمایش پایدار وضعیت روی پنل برای حداقل یک نشست آزمایشی بدون قفل شدن UI؛ موفقیت ۱۰ پالس متوالی بدون گیر کردن رله در حالت روشن؛ تشخیص قطع UART و ورود به حالت امن در کمتر از یک بازهٔ پایش؛ و عدم روشن شدن همزمان دو پمپ در آزمون mutex. معیارهای کمی دقیق (دقت رطوبت برحسب درصد مطلق) نیازمند کالیبراسیون و ابزار مرجع است و فعلاً به‌عنوان هدف بعدی ثبت می‌شود.

## ۵-۵ محدودیت‌های ارزیابی فعلی

نبود جدول اندازه‌گیری تکرارپذیر در مخزن به معنای شکست پروژه نیست، بلکه مرز گزارشگری علمی را مشخص می‌کند. هر ادعای عددی بدون داده، اعتبار گزارش را کم می‌کند؛ بنابراین این فصل عمداً روی سناریو و معیار پذیرش متمرکز شده است. پیشنهاد می‌شود در نسخهٔ بعدی گزارش، سه روز داده با نرخ نمونه‌برداری ثابت و شرح شرایط محیطی افزوده شود.

## ۵-۶ ریسک‌ها و کاهش آن‌ها

ریسک سرریز آب با پالس و نظارت سطح مخزن کاهش می‌یابد. ریسک سوختن پمپ خشک با بررسی حسگر سطح و سقف زمانی کاهش می‌یابد. ریسک قفل شدن سامانه پس از خطای شبکه با حالت Fault و مسیر بازیابی کنترل‌شده مدیریت می‌شود. ریسک افشای اسرار با حذف از گزارش و استفاده از پیکربندی محلی کنترل می‌شود.

# فصل ۶ — نتیجه‌گیری و کارهای آینده

## ۶-۱ نتیجه‌گیری

در این پروژه یک سامانهٔ پایش و آبیاری هوشمند گلدون با معماری چندبرد مبتنی بر ESP32 طراحی و پیاده‌سازی شد. نقش‌های حیاط، مودم و پنل از هم تفکیک شدند تا ارتباط UART پایدار حسگر/عملگر با واسط HTTP کاربری و میزبان ترکیب شود. موتور پایتونی میزبان با سیاست‌های پالس آبیاری، قفل متقابل پمپ‌ها و مدیریت خطا، لایهٔ ایمنی را خارج از میان‌افزارهای سبک نگه داشت. مستندسازی بدون افشای اسرار شبکه انجام شد. ارزیابی فعلی بر سناریوهای منطقی استوار است و اندازه‌گیری کمی نظام‌مند به‌عنوان ادامهٔ کار پیشنهاد می‌شود.

## ۶-۳ درس‌آموخته‌های مهندسی

مهم‌ترین درس‌آموخته این است که در سامانه‌های IoT دانشجویی، تفکیک نقش و لایهٔ ایمنی صریح بیش از افزودن حسگرهای جدید ارزش دارد. همچنین مستندسازی معماری (boards) و ساختار پوشه، هزینهٔ ادامهٔ کار توسط خود دانشجو یا داور را به‌شدت کم می‌کند. در نهایت، مقاومت در برابر وسوسهٔ عددسازی برای فصل ارزیابی، بخشی از اخلاق مهندسی است.

## ۶-۲ کارهای آینده

• ثبت دادهٔ تجربی چندروزه و تحلیل آماری رطوبت خاک قبل/بعد آبیاری پالسی.

• کالیبراسیون دقیق حسگرهای خاک برای بستر کشت مشخص و ذخیرهٔ منحنی کالیبراسیون در پیکربندی.

• افزودن احراز هویت ساده روی HTTP محلی (توکن قابل چرخش) بدون وابستگی ابری.

• بهبود UI پنل با هشدارهای فارسی خوانا و حالت نگهداری (maintenance).

• پایش مصرف انرژی و دمای رله/پمپ برای نگهداری پیشگیرانه.

• آزمون میدان در شرایط واقعی حیاط و مستندسازی دماهای تابستانی سیرجان در تصمیم آبیاری.

• در صورت نیاز آموزشی، تکمیل شماتیک Altium تا سطح PCB قابل ساخت.

# منابع

[1] Espressif Systems, “ESP32 Series Datasheet,” Espressif, online documentation.

[2] Espressif Systems, “ESP32-S3 Series Datasheet,” Espressif, online documentation.

[3] Espressif Systems, “ESP32-C6 Series Datasheet,” Espressif, online documentation.

[4] Espressif Systems, ESP-IDF Programming Guide, online.

[5] Arduino, “Arduino Core for the ESP32,” GitHub / documentation.

[6] Adafruit Industries, DHT11/DHT22 humidity & temperature sensor notes, online learning guides.

[7] ILITEK, ILI9341 TFT Controller Datasheet.

[8] Texas Instruments / common vendor datasheets, ULN2003A Darlington Transistor Arrays.

[۹] A. Al-Fuqaha et al., “Internet of Things: A Survey on Enabling Technologies, Protocols, and Applications,” IEEE Commun. Surveys Tuts., 2015.

[۱۰] R. Buyya and A. V. Dastjerdi (Eds.), Internet of Things: Principles and Paradigms, Morgan Kaufmann.

[۱۱] Waveshare, “ESP32-C6-LCD-1.47” product wiki / schematic notes.

[۱۲] مستندات داخلی پروژهٔ گلدون هوشمند: docs/boards.md، ساختار firmware/* و host/goldon.

[۱۳] IETF, RFC 2616/7230 family — HTTP concepts (for local API style discussion).

[۱۴] Python Software Foundation, Python Packaging & PyYAML documentation (configuration patterns).

# پیوست‌ها

## پیوست الف — پین‌مپ خلاصهٔ گرهٔ حسگر/عملگر (ESP32-S3)

بر اساس راهنمای شماتیک کمکی پروژه (بستهٔ Altium/نت‌لیست):

سیگنال | پایهٔ پیشنهادی ESP32-S3 | توضیح
SOIL1 AO | GPIO1 | رطوبت خاک کانال ۱
SOIL2 AO | GPIO2 | رطوبت خاک کانال ۲
DHT DATA | GPIO4 | دما/رطوبت هوا
AP3216 SDA | GPIO8 | I2C داده
AP3216 SCL | GPIO9 | I2C ساعت
WATER S | GPIO12 | سطح آب
RELAY1 via ULN | GPIO10 | پمپ ۱
RELAY2 via ULN | GPIO11 | پمپ ۲
لینک UART به مودم | مطابق طراحی Modem↔Yard | TX/RX ضربدری؛ جزئیات در شماتیک docs

توجه: در معماری نهایی، ارتباط خارجی حیاط از مسیر Modem Bridge است و نباید با طرح‌های تک‌بردی قدیمی که مودم سلولی را مستقیم روی همان برد می‌نشانند اشتباه گرفته شود. منبع حقیقت معماری نرم‌افزاری، مستند boards و میان‌افزارهای فعلی است.

## پیوست ب — اشاره به شماتیک و BOM

فهرست قطعات و نت‌لیست کمکی برای ترسیم در Altium در بستهٔ شماتیک پروژه موجود است و شامل ESP32-S3، حسگرهای خاک/DHT/نور/سطح آب، ULN2003، رله‌ها و پمپ‌ها می‌شود. توصیه می‌شود پیش از ساخت PCB، ERC انجام شود و کانال‌های استفاده‌نشدهٔ ULN باز بمانند. جزئیات فایل‌ها در پوشهٔ مستندات/شماتیک مخزن آمده است.

## پیوست ج — گزیدهٔ ساختار پوشه‌ها

goldon hoshmand/
docs/
boards.md
project-report/
گزارش-پروژه-گلدون-هوشمند.docx
firmware/
yard_api/
modem_bridge/
panel_status/
c6_splash/
host/
goldon/ # cli, engine, safety, weather, AI optional

## پیوست د — نکات ایمنی کاربری

هرگز پمپ را بدون بررسی مخزن و مسیر آب برای مدت نامشخص روشن نگذارید. در آزمون‌ها از حالت پالس استفاده کنید. تغذیه را با رعایت قطبیت و جداسازی نسبی منطق/قدرت وصل کنید. اسرار شبکه را در مخازن عمومی قرار ندهید.

## پیوست هـ — واژه‌نامهٔ کوتاه فارسی

آبیاری پالسی: تزریق آب در بازه‌های کوتاه متناوب به‌جای جریان پیوسته.

قفل متقابل: سازوکاری که از تملک همزمان یک منبع مشترک توسط دو فرایند جلوگیری می‌کند.

پل مودم: گره‌ای که پروتکل/رسانه را ترجمه می‌کند؛ در این پروژه UART را به HTTP محلی پیوند می‌دهد.

حالت امن: وضعیتی که عملگرهای خطرناک خاموش و پرچم خطا فعال است.

## پیوست و — چک‌لیست تحویل

□ میان‌افزارهای Yard/Modem/Panel فلش شده و نسخه مشخص است.

□ پیکربندی نمونه بدون راز در docs قرار دارد.

□ گزارش Word و در صورت نیاز PDF تولید شده است.

□ جدول سناریوهای آزمون منطقی مرور شده است.

□ شماتیک/BOM برای داور قابل ارجاع است.

□ هیچ SSID/رمز/کلید واقعی در گزارش نیست.

پایان گزارش

محمد تدین

سیستم آبیاری و پایش هوشمند گلدون (IoT)
