Artemis-98/goldon/host/plants/README.txt

# عکس گیاه‌ها را اینجا بگذار:
#   plant_a.jpg
#   plant_b.jpg
# مسیر در config.yaml → plants[].photo
