Artemis-98/goldon/docs/project-report/assets/README.md

# منابع خوشنویسی بسم‌الله

| فایل | منبع | مجوز |
| --- | --- | --- |
| `bismillah.svg` | [Wikimedia — Bismillah Calligraphy5.svg](https://commons.wikimedia.org/wiki/File:Bismillah_Calligraphy5.svg) (Warraich Sahib) | CC0 |
| `bismillah-alt.svg` | [Wikimedia — Bismillah Calligraphy6.svg](https://commons.wikimedia.org/wiki/File:Bismillah_Calligraphy6.svg) | CC0 |
| `bismillah-cover.svg` | نسخهٔ تک‌رنگ چاپ از Calligraphy5 | CC0 (مشتق) |
| `bismillah-freesvg.png` | FreeSVG / OpenClipart | Public Domain |
| `bismillah-recreated.png` | بازسازی برای جلد گزارش (چاپ A4) | بر پایهٔ منبع CC0 |

در قالب از `bismillah-recreated.png` استفاده شده است.
