Artemis-98/goldon/docs/project-report/قالب-تحقیق-گلدون-هوشمند.pptx

دانشجو: محمد تدین | سیستم آبیاری و پایش هوشمند گلدون (IoT) تاریخ: … / … / … صفحه : 1 از 10 | نام استاد: …

چکیده

عنوان تحقیق:
سیستم آبیاری و پایش هوشمند گلدون (IoT)
نام دانشجو و اعضای تیم:
محمد تدین
استاد:
…
زمان انجام پروژه: …
[متن چکیده اینجا نوشته می‌شود]

## Slide 2

دانشجو: محمد تدین | سیستم آبیاری و پایش هوشمند گلدون (IoT) تاریخ: … / … / … صفحه : 2 از 10 | نام استاد: …

فهرست مطالب

چکیده .................................................... ۱
فهرست مطالب .............................................. ۲
فهرست شکل‌ها .............................................. ۳
فهرست جدول‌ها ............................................. ۴
۱- مقدمه ................................................. ۵
۱-۱- پیش‌گفتار ...................................... ۵
۱-۱-۱- کلیات گزارش ................................. ۵
۱-۱-۲- ساختار تحقیق ................................ ۶
۲- بدنه اصلی تحقیق ...................................... ۷
۲-۱- زیرفصل شماره ۱ ................................ ۷
۲-۲- زیرفصل شماره ۲ ................................ ۷
۳- جمع‌بندی و نتیجه‌گیری ................................. ۸
۳-۱- نتیجه‌گیری ..................................... ۸
۳-۲- پیشنهاد برای ادامه کار ........................ ۸
۳-۳- تقدیر و تشکر .................................. ۸
۴- مراجع .................................................. ۹

## Slide 3

دانشجو: محمد تدین | سیستم آبیاری و پایش هوشمند گلدون (IoT) تاریخ: … / … / … صفحه : 3 از 10 | نام استاد: …

فهرست شکل‌ها

شکل (۱-۱) … ................................................. ۵
شکل (۱-۲) … ................................................. ۶
شکل (۲-۱) … ................................................. ۷
[عناوین شکل‌ها بعداً تکمیل می‌شود]

## Slide 4

دانشجو: محمد تدین | سیستم آبیاری و پایش هوشمند گلدون (IoT) تاریخ: … / … / … صفحه : 4 از 10 | نام استاد: …

فهرست جدول‌ها

جدول (۱-۱) … ............................................... ۵
[عناوین جدول‌ها بعداً تکمیل می‌شود]

## Slide 5

دانشجو: محمد تدین | سیستم آبیاری و پایش هوشمند گلدون (IoT) تاریخ: … / … / … صفحه : 5 از 10 | نام استاد: …

۱- مقدمه

۱-۱- پیش‌گفتار
[متن پیش‌گفتار]
۱-۱-۱- کلیات گزارش
[متن کلیات گزارش]
شکل (۱-۱) …
جدول (۱-۱) …

## Slide 6

دانشجو: محمد تدین | سیستم آبیاری و پایش هوشمند گلدون (IoT) تاریخ: … / … / … صفحه : 6 از 10 | نام استاد: …

۱-۱-۲- ساختار تحقیق

[توضیح ساختار فصول]
شکل (۱-۲) نمودار مطالب فصول
فصل اول
• …
فصل دوم
• …
فصل سوم
• …

## Slide 7

دانشجو: محمد تدین | سیستم آبیاری و پایش هوشمند گلدون (IoT) تاریخ: … / … / … صفحه : 7 از 10 | نام استاد: …

۲- بدنه اصلی تحقیق

این فصل شامل بخش اصلی تحقیق است.
۲-۱- زیرفصل شماره ۱
[متن]
شکل (۲-۱) …
۲-۲- زیرفصل شماره ۲
[متن]

## Slide 8

دانشجو: محمد تدین | سیستم آبیاری و پایش هوشمند گلدون (IoT) تاریخ: … / … / … صفحه : 8 از 10 | نام استاد: …

۳- جمع‌بندی و نتیجه‌گیری

۳-۱- نتیجه‌گیری
[متن]
۳-۲- پیشنهاد برای ادامه کار
[متن]
۳-۳- تقدیر و تشکر
[متن]

## Slide 9

دانشجو: محمد تدین | سیستم آبیاری و پایش هوشمند گلدون (IoT) تاریخ: … / … / … صفحه : 9 از 10 | نام استاد: …

۴- مراجع

[۱] …
[۲] …
[۳] …

## Slide 10

دانشجو: محمد تدین | سیستم آبیاری و پایش هوشمند گلدون (IoT) تاریخ: … / … / … صفحه : 10 از 10 | نام استاد: …
