Artemis-98/goldon/docs/project-report/گزارش-پروژه-قالب.docx

عنوان تحقیق:

طراحی و پیاده‌سازی سیستم پایش و آبیاری هوشمند گلدون مبتنی بر ESP32 و ارتباط بی‌سیم

نام دانشجو:

محمد تدین

شماره دانشجویی:

3060443106

استاد راهنما

دکتر حمید رضا لظفعلی شمیرانی

زمان انجام پروژه: ........................

## چکیده

در بخش چکیده بایستی آنچه در تحقیق قرار است انجام شود را بصورت مختصر و با استفاده از کمترین کلمات ممکن بیان کرد. معمولا چکیده بین 100 الی 300 کلمه را شامل میشود.

## فهرست مطالب

فهرست جدولها

# 1- مقدمه

## 1-1 - پیش گفتار

در مقدمه به ماهیت کار، هدف، ضرورت و اهمیت کار، مواد پژوهش، روش تحقيق،...اشاره مي شود.

### 1-1-1 - کلیات گزارش

در این قسمت یک معرفی کلی از کار انجام خواهد شد. ضمن اینکه چهارچوبی که قرار است تحقیق در آن انجام شود نیز در این بخش مشخص میگردد در صورت لزوم میتوان از شکلها و جداول نیز استفاده کرد.

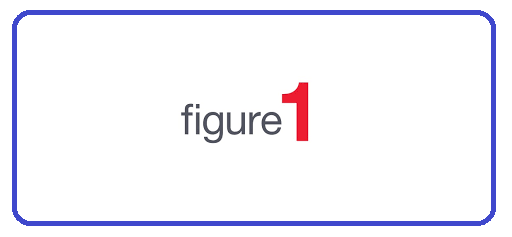
[picture p14: figure]

            شکل (1-1) توضیحات مربوط به شکل اول.

همچنین همانطور که گفته شد، از جداول نیز میتوان برای شرح مطالب استفاده نمود. در ادامه فرمت یک جدول نشان داده شده است.

            جدول (1-1) توضیحات مربوط به جدول اول.

مقدار | نام پارامتر

### 1-1-2 - ساختار تحقيق

در این قسمت میتوان ساختار تحقیق و پیکربندی فصول گزارش را بیان نمود. بعنوان مثال فصل اول به بررسی ... میپردازد. در فصل دوم جنبههای مختلف ... مورد مطالعه قرار میگیرد. فصل آخر نیز به ... اختصاص دارد.

فصل اول
توضیح مربوط به فصل اول
توضیح مربوط به فصل اول
فصل دوم
توضیح مربوط به فصل دوم
توضیح مربوط به فصل دوم
فصل سوم
توضیح مربوط به فصل سوم
توضیح مربوط به فصل سوم

            شکل (1-1) نمودار مطالب ارائه شده در فصلهای مختلف.

# 2- بدنه اصلي تحقيق

این فصل شامل بخش اصلی تحقیق است. در این فصل کل کار انجام شده با جزئیات آن ذکر میگردد. البته در صورت گسترده بودن تحقیق، میتوان مطالب را در چندین فصل آورد.

## 2-1 - زیر فصل شماره 1

میتوان مطالب را به چندین زیرفصل تقسیم بندی نمود. بعنوان مثال میتوان مروری بر کارهایی که در دنیا روی این موضوع صورت گرفته را در زیرفصل اول آورد و در زیرفصلهای بعدی به بحث اصلی تحقیق پرداخت. بدیهی است این امربسته به نوع تحقیق میتواند متفاوت باشد. در اینجا نیز میتوان از تصاویر برای شرح بهتر متن استفاده نمود.

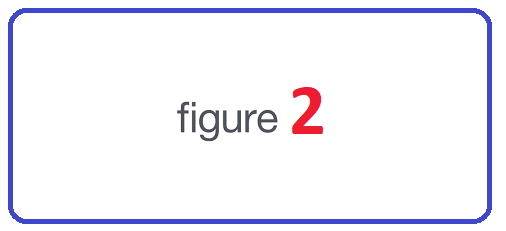
[picture p15: figure]

            شکل (2-1) توضیحات مربوط به شکل.

## 2-2 - زیر فصل شماره 2

زیربخش دوم نیز میتواند بخش دیگری از تحقیق را شامل گردد. بعنوان مقال میتوان در این بخش به بیان مسئله اصلی که تحقیق به آن اختصاص دارد پرداخت. مثلا میتوان روابط عددی و فرمولی را بیان کرد. بعنوان مثال فرمول زیر میتواند بخشی از تحقیق باشد:

            (2-1) A_1 =B_1 +C_1
            (2-2) D_1 =A_1 -G_1

البته خود زیربخش دوم هم میتواند شامل دو زیرزیر بخش باشد:

### 2-2-1 - زیرزیربخش اول

ابن بخش میتواند حاوی بخشی از گزارش تحقیق باشد.

### 1-1-1 - زیرزیربخش اول

ابن بخش نیز میتواند حاوی بخشی از گزارش تحقیق باشد.

# 1- جمع بندي و نتيجه گيري

در این بخش بایستی کل نتایج تحقیق بصورت خلاصه ذکر گردد. بهتر است از نمودار و جداول کمکی برای نتیجهگیری و مقایسه نتایج استفاده گردد. اینفصل میتواند شامل بخشهای زیر باشد:

## 2-3 - نتيجه گيري

مطالب مربوط به نتيجهگيري ذکر گردد.

## 2-4 - پيشنهاد براي ادامه کار

در اين بخش پيشنهادهايي براي ادامه راه اين تحقيق بيان گردد

## 2-5 - تقدير و تشکر

اسامي کساني که قرار است از آنها تقدير و تشکر صورت پذيرد در اين بخش قيد ميگردد.

# 3- مراجع

در اين بخش منابع و مراجع علمي تحقيق ذکر ميگردد. بعنوان مثال تعدادي مرجع در زير قرار داده شده است:

[1] C. Bowick, RF Circuit Design, Second Edition, 2 edition. Amsterdam ; Boston: Newnes, 2007.
[2] B. Razavi, RF Microelectronics, 2 edition. Upper Saddle River, NJ: Prentice Hall, 2011.
[3] V. Giannini, J. Craninckx, and A. Baschirotto, Baseband Analog Circuits for Software Defined Radio, 2008 edition. Sheffield (Eng.): Springer, 2008.
[4] “AD9262 Datasheet and Product Info | Analog Devices.” [Online]. Available: http://www.analog.com/en/products/analog-to-digital-converters/ad-converters/ad9262.html#product-documentation. [Accessed: 12-Sep-2016].

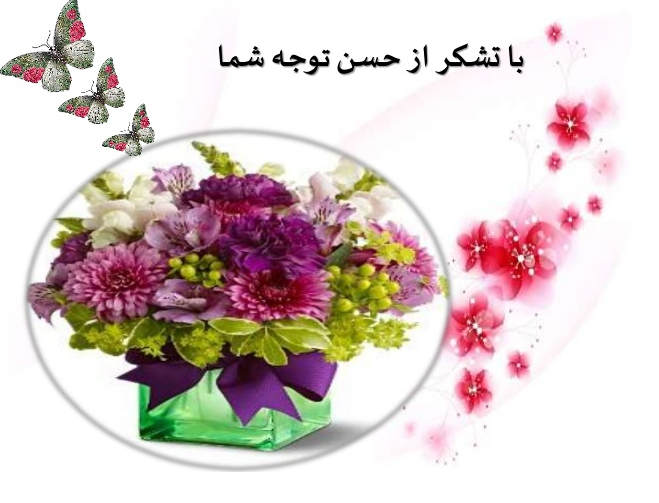
[picture p16: figure]

نام استاد: ... عنوان تحقيق دانشجويي تاريخ: 09/09/1404 صفحه : 11 از 11 برای ادیت این بخش اینجا دوبار کلیک کنید دانشجو: ...
