Artemis-98/goldon/docs/project-report/assets/bismillah-freesvg.png

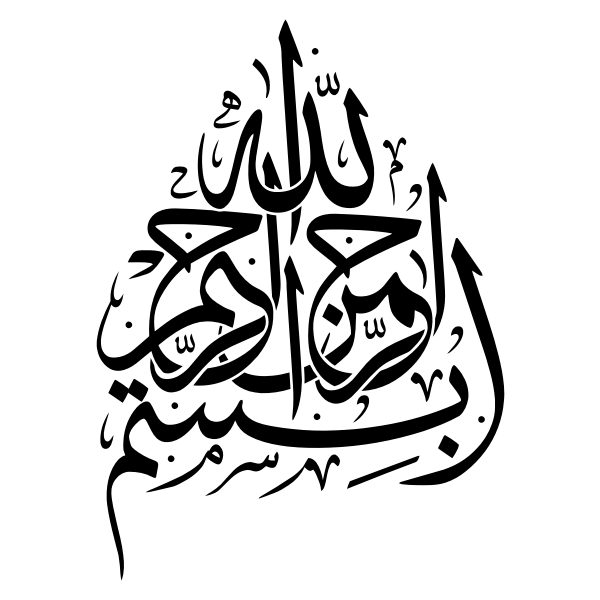
docs/project-report/assets/bismillah-freesvg.png
