Artemis-98/goldon/docs/project-report/assets/hardware/esp32.jpg

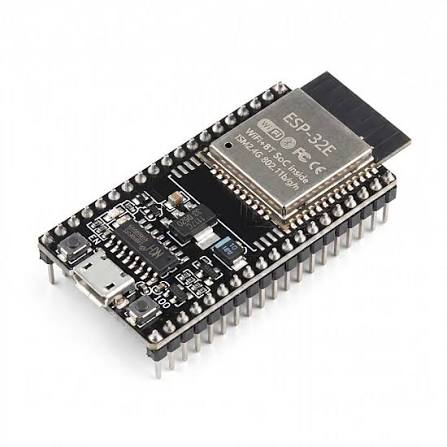
docs/project-report/assets/hardware/esp32.jpg
