Artemis-98/goldon/docs/project-report/assets/hardware/hw-esp32-bw.png

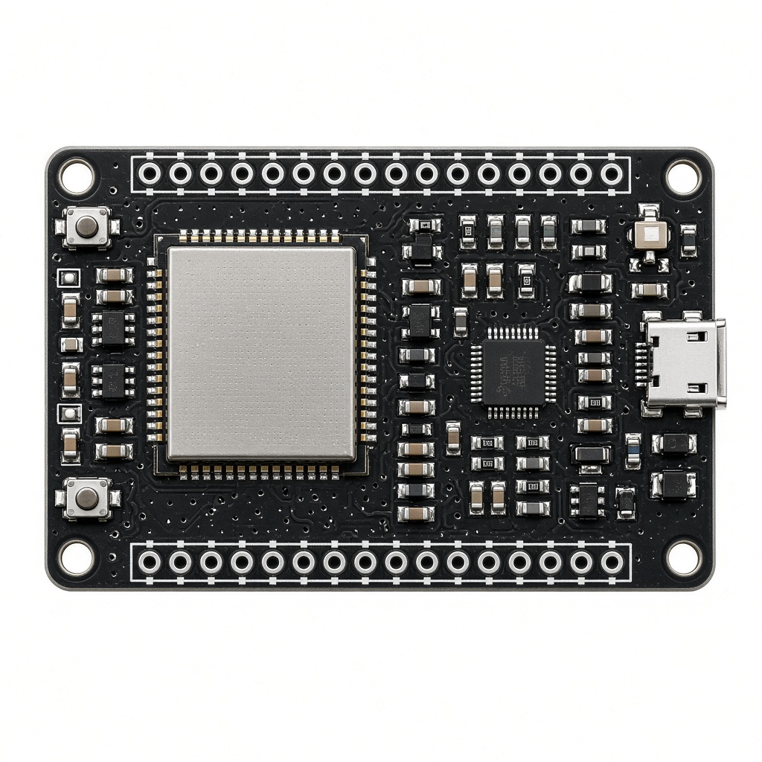
docs/project-report/assets/hardware/hw-esp32-bw.png
