Artemis-98/goldon/docs/project-report/assets/hardware/hw-modules-plate-bw.png

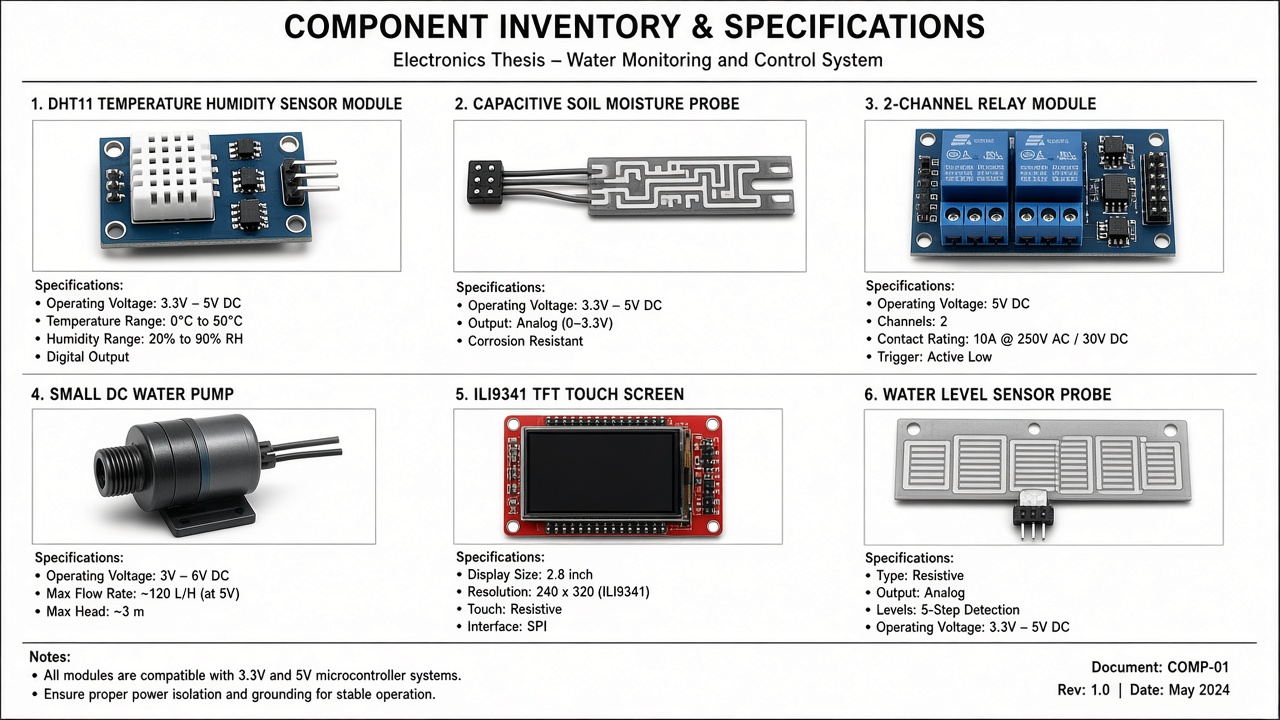
docs/project-report/assets/hardware/hw-modules-plate-bw.png
