Artemis-98/goldon/docs/project-report/assets/hardware/hw-relay-bw.png

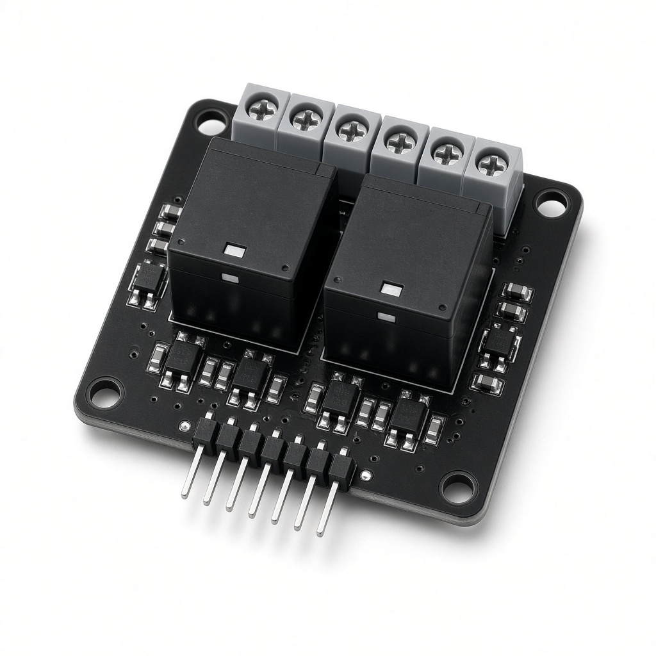
docs/project-report/assets/hardware/hw-relay-bw.png
