Artemis-98/goldon/docs/project-report/assets/hardware/hw-uln2003-bw.png

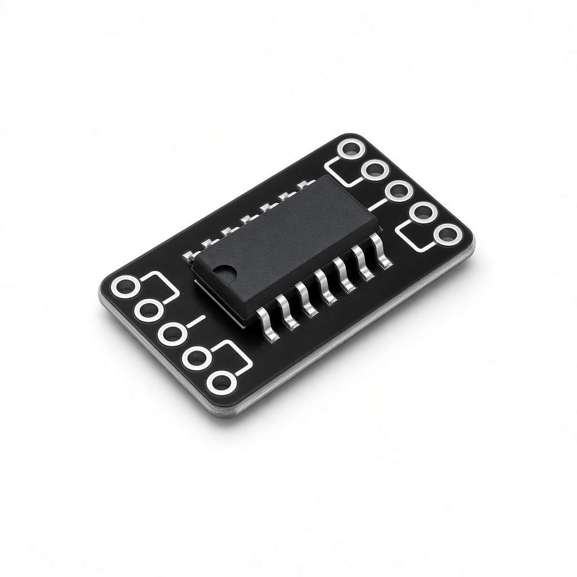
docs/project-report/assets/hardware/hw-uln2003-bw.png
