Artemis-98/goldon/docs/altium/Sheet4-ULN2003-guide.txt

================================================================================
شیت ۴ — ULN2003AN (U3)  |  گلدون هوشمند
توجه: ULN سنسور نیست؛ درایور دارلینگتون برای رله است.
================================================================================

چطور در Altium بسازی / بگذاری
------------------------------
روش سریع (پیشنهادی):
  1. در شیت Schematic: Place → Part  (یا P P)
  2. Manufacturer Part Search / Components panel
  3. جستجو: ULN2003AN  (یا ULN2003A)
  4. یک سمبل DIP-16 از TI یا ST بگیر و Place کن
  5. Designator را بگذار: U3
  6. نت‌ها را طبق جدول پایین وصل کن

روش دستی با فایل‌های این پوشه:
  A) Symbol Wizard
     - File → New → Library → Schematic Library
     - Tools → Symbol Wizard
     - Import / Paste از فایل: ULN2003AN-pins.csv
     - Layout: DIP Left/Right ، ۱۶ پین
     - Save به‌نام ULN2003AN.SchLib
  B) اسکریپت
     - یک SchLib جدید باز کن
     - File → Run Script → Create_ULN2003AN.pas
     - Save ، بعد Place → Part روی شیت ۴

================================================================================
پین‌اوت فیزیکی (ناچ بالا — پین ۱ چپ بالا)
================================================================================

   1B  1 ●───────────● 16  1C
   2B  2 ●───────────● 15  2C
   3B  3 ●    U3     ● 14  3C
   4B  4 ●  ULN2003  ● 13  4C
   5B  5 ●           ● 12  5C
   6B  6 ●           ● 11  6C
   7B  7 ●───────────● 10  7C
  GND  8 ●───────────●  9  COM

================================================================================
اتصالات پروژه (فقط همین‌ها را نت بزن)
================================================================================

پین  نام    نت Altium      وصل به
---- -----  -------------  -------------------------
1    1B     RLY1_IN_B      U1 (ESP32) GPIO10
2    2B     RLY2_IN_B      U1 (ESP32) GPIO11
8    GND    GND            زمین کنترل مشترک
9    COM    +5V_BANK       پاوربانک ۵V (دیودهای داخلی — الزامی)
15   2C     RLY2_IN        K2 (رله۲) پایه IN
16   1C     RLY1_IN        K1 (رله۱) پایه IN

باز بمانند (No ERC / No Connect روی پین):
  3, 4, 5, 6, 7, 10, 11, 12, 13, 14
  Place → Directives → Place No ERC  روی هر پین باز

================================================================================
مسیر سیگنال روی شیت
================================================================================

  U1.GPIO10 ──── net RLY1_IN_B ──── U3.1B
                                        │ (داخل چیپ)
                                   U3.1C ──── net RLY1_IN ──── K1.IN

  U1.GPIO11 ──── net RLY2_IN_B ──── U3.2B
                                        │
                                   U3.2C ──── net RLY2_IN ──── K2.IN

  +5V_BANK ──── U3.COM (پین۹) ، همچنین K1.VCC و K2.VCC
  GND      ──── U3.GND (پین۸) ، همچنین K1.GND و K2.GND

رله → پمپ (همان شیت):
  +3V_PUMP ──── K1.COM و K2.COM
  K1.NO ──── PUMP1.+
  K2.NO ──── PUMP2.+
  PUMP1.- و PUMP2.- ──── GND_PUMP

================================================================================
اشتباهات رایج
================================================================================
✗ GPIO مستقیم به IN رله
✗ COM (پین۹) را GND کردن — باید به +5V برود
✗ 5VIN ماژول رله را از 3.3V ESP گرفتن
✗ فراموش کردن No ERC روی کانال‌های خالی → هشدار ERC زیاد

✓ مسیر درست: GPIO → پایه B روی ULN → پایه C روی ULN → IN رله
