Artemis-98/goldon/docs/wiring-diagram.html

# سیم‌کشی گلدون هوشمند — برد حیاط (ESP32-S3)

ESP32-S3-N8R2 + SIM800L EVB + سنسورها + پمپ 3V + تامین برق خودکفا

شماتیک دقیق اتصالات و نت‌لیست ←

## راهنمای رنگ سیم‌ها

قرمز = 5V

آبی روشن = 3.3V سنسور / SIM VDD

مشکی = GND

نارنجی = سیگنال / ULN

زرد = SIM TXD

سبز = SIM RXD

آبی = I2C SDA

بنفش = I2C SCL

راهنما: برای سیم‌کشی دقیق از بخش‌های متنی و جداول پایین استفاده کن.

## خازن ۱۰۰۰µF — کجا بگذارم؟ + و − کدام است؟

این خازن الکترولیت است و قطب دارد. اگر برعکس بزنی باد می‌کند یا می‌ترکد. جای درست: موازی روی تغذیه SIM800L — پایهٔ مثبت به 5VIN، پایهٔ منفی به GND، هرچه نزدیک‌تر به ماژول بهتر.

### اتصال دقیق

پایه خازن | تشخیص | وصل به
+ | بدون نوار / پایه بلند | SIM800L 5VIN و +5V پاوربانک
− | نوار تیره با علامت − / پایه کوتاه | SIM800L GND و GND مشترک

قواعد جاگذاری:

- خازن را موازی بگذار (نه سری در مسیر سیم). یعنی هم 5VIN و هم GND همچنان به پاوربانک وصل‌اند؛ خازن فقط بین همان دو نقطه می‌نشیند.
- حداکثر ۲–۳ سانتی‌متر از پین‌های 5VIN و GND ماژول فاصله داشته باشد. روی بردبرد اگر دور باشد اثرش کم می‌شود.
- ولتاژ خازن: حداقل ۱۰V، بهتر ۱۶V یا ۲۵V. روی 5V از خازن 6.3V استفاده نکن.
- این خازن مال جهش جریان SIM است (هنگام ارسال GPRS). روی پمپ یا ESP لازم نیست همین را بگذاری.

## اتصال دو رله با ULN2003 و منبع تغذیه جدا

رله را مستقیم به GPIO نزن. مسیر درست: ESP32 → ULN2003 → IN رله → پمپ ۳V. دیود flyback جدا لازم نیست؛ دیودهای داخل ULN با وصل پین ۹ به ۵V فعال می‌شوند.

### دو منبع برق

منبع ۵ ولت (پاوربانک)

کویل رله‌ها · پین ۹ (COM) روی ULN · تغذیه کنترل

منبع ۳ ولت (جدا)

فقط پمپ‌ها از طریق COM و NO رله — مستقیم به ESP وصل نشود

### گام‌به‌گام سیم‌کشی

1. اول ULN2003 را بگذار
  ناچ (فرورفتگی) بالا باشد. پین ۱ سمت چپ بالاست.
  پین ۱ — 1B ← ESP32 GPIO 10 نارنجی
  پین ۲ — 2B ← ESP32 GPIO 11 نارنجی
  پین ۸ — GND ← GND مشترک مشکی
  پین ۹ — COM ← ۵V پاوربانک قرمز · الزامی
  پین ۱۶ — 1C → IN رله ۱ نارنجی
  پین ۱۵ — 2C → IN رله ۲ نارنجی
2. رله ۱ (پمپ گیاه ۱)
  VCC رله ← ۵V پاوربانک قرمز
  GND رله ← GND مشترک مشکی
  IN رله ← ULN پین ۱۶ (1C) نه از ESP
3. رله ۲ (پمپ گیاه ۲)
  VCC رله ← ۵V پاوربانک قرمز
  GND رله ← GND مشترک مشکی
  IN رله ← ULN پین ۱۵ (2C) نه از ESP
4. منبع ۳ ولت و پمپ‌ها (ترمینال بزرگ رله)
  برای هر پمپ همین الگو را تکرار کن.
  + منبع ۳V → COM رله زرد / قرمز
  NO رله → + پمپ سبز
  − پمپ → − منبع ۳V مشکی

### جدول خلاصه اتصالات

از | به | رنگ پیشنهادی | توضیح
GPIO 10 | ULN پین ۱ (1B) | نارنجی | سیگنال رله ۱
GPIO 11 | ULN پین ۲ (2B) | نارنجی | سیگنال رله ۲
ULN پین ۸ | GND مشترک | مشکی | زمین کنترل
ULN پین ۹ | ۵V پاوربانک | قرمز | دیودهای داخلی ULN
ULN پین ۱۶ | IN رله ۱ | نارنجی | خروجی کانال ۱
ULN پین ۱۵ | IN رله ۲ | نارنجی | خروجی کانال ۲
VCC هر رله | ۵V پاوربانک | قرمز | کویل رله
GND هر رله | GND مشترک | مشکی | زمین کنترل
+ منبع ۳V | COM هر رله | قرمز | برق پمپ
NO هر رله | + پمپ مربوط | سبز | سوییچ پمپ
− پمپ | − منبع ۳V | مشکی | برگشت پمپ

نکات مهم:

- GPIO را مستقیم به IN رله وصل نکن؛ حتماً از ULN رد شود.
- دیود جدا لازم نیست — پین ۹ ULN را به ۵V وصل کن.
- ماژول رله معمولاً LOW-trigger است: digitalWrite(10, HIGH) = پمپ ۱ روشن.
- اول بدون پمپ تست کن (فقط صدای کلیک رله)، بعد منبع ۳V و پمپ را وصل کن.
- GND کنترل (ESP و ULN و رله) مشترک باشد؛ مسیر ۳V پمپ می‌تواند جدا بماند.

## خلاصه پین‌های ULN2003AN

چیپ را طوری بگیر که نقطه/فرورفتگی (notch) بالا باشد. پین ۱ سمت چپ بالاست. فقط پین‌های قرمز را در این پروژه استفاده کن — بقیه خالی بمانند.

### خلاصه — فقط ۶ پین وصل شود

پین IC | نام | سیم به | رنگ
۱ | 1B | ESP32 GPIO 10 | نارنجی
۲ | 2B | ESP32 GPIO 11 | نارنجی
۸ | GND | GND مشترک (همه ماژول‌ها) | مشکی
۹ | COM | +5V پاوربانک | قرمز
۱۵ | 2C | IN ماژول رله ۲ | نارنجی
۱۶ | 1C | IN ماژول رله ۱ | نارنجی

نکات مهم:

- پین‌های ۳ تا ۷ (ورودی) و ۱۰ تا ۱۴ (خروجی) را وصل نکن.
- پین ۹ (COM) را به 5V وصل کن تا دیودهای داخلی هنگام قطع رله ولتاژ القایی را خنثی کنند.
- رله: VCC→5V، GND→مشترک، IN→1C یا 2C (مستقیم به ESP نه).
- روی breadboard: چیپ را طوری بگذار که notch رو به بالا باشد؛ پین ۱ جلوی چپ.

## جدول کامل اتصال پین‌ها

ماژول | پین ماژول | رنگ سیم | پین ESP32-S3 | توضیح
SIM800L EVB ترتیب روی برد: 5VIN · GND · VDD · TXD · RXD · GND · RST | 5VIN | قرمز | خروجی 5V پاوربانک | نه از پین 5V برد ESP — پاوربانک 5V/2A. خازن ۱۰۰۰µF موازی بین 5VIN و GND
| GND (اول) | مشکی | GND | GND مشترک + پایه − خازن
| VDD | آبی روشن | 3.3V ESP | سطح منطقی UART — نه 5V
| TXD | زرد | GPIO 16 (RX) | SIM TX → ESP RX
| RXD | سبز | GPIO 17 (TX) | SIM RX → ESP TX
| GND (دوم) | مشکی | GND | همان GND مشترک — هر دو یکی‌اند
| RST | نارنجی | GPIO 18 (اختیاری) | Reset نرم‌افزاری ماژول
خازن ۱۰۰۰µF | + (بدون نوار / پایه بلند) | قرمز | SIM 5VIN و +5V پاوربانک | موازی روی تغذیه SIM — نه سری در سیم
| − (نوار تیره / پایه کوتاه) | مشکی | SIM GND | نزدیک ماژول؛ ولتاژ ۱۶V یا ۲۵V
رطوبت خاک 1 (HW-103) | VCC | آبی روشن | 3.3V | نه 5V
| GND | مشکی | GND
| AO | نارنجی | GPIO 1 | مقدار آنالوگ — گیاه 1
| DO | — | — | استفاده نکن
رطوبت خاک 2 (HW-103) | VCC | آبی روشن | 3.3V | نه 5V
| GND | مشکی | GND
| AO | نارنجی | GPIO 2 | مقدار آنالوگ — گیاه 2
DHT11 | VCC | آبی روشن | 3.3V | نه 5V
| GND | مشکی | GND
| DATA | نارنجی | GPIO 4 | دما + رطوبت هوا
AP3216 (نور) | VCC | آبی روشن | 3.3V | نه 5V
| GND | مشکی | GND
| SDA | آبی | GPIO 5 | I2C Data
| SCL | بنفش | GPIO 9 | I2C Clock
سنسور سطح آب | + (VCC) | آبی روشن | 3.3V | نه 5V
| − (GND) | مشکی | GND
| S (Signal) | نارنجی | GPIO 7 | HIGH = آب موجود
ULN2003AN | 1B (پین ۱) | نارنجی | GPIO 10 | ورودی کانال ۱
| 1C (پین ۱۶) | نارنجی | IN رله ۱ | خروجی کانال ۱
| 2B (پین ۲) | نارنجی | GPIO 11 | ورودی کانال ۲
| 2C (پین ۱۵) | نارنجی | IN رله ۲ | خروجی کانال ۲
| 8 GND | مشکی | GND | مشترک
| 9 COM | قرمز | 5V | دیودهای داخلی ULN — دیود جدا لازم نیست
رله 1 (پمپ 1) | VCC | قرمز | 5V پاوربانک
| GND | مشکی | GND
| IN | نارنجی | ULN2003 1C | نه مستقیم از ESP
رله 2 (پمپ 2) | VCC | قرمز | 5V پاوربانک
| GND | مشکی | GND
| IN | نارنجی | ULN2003 2C | نه مستقیم از ESP
پمپ 3V (هر کدام) | + | قرمز | NO رله ← COM منبع 3V | مستقیم به ESP وصل نشود
| − | مشکی | GND منبع 3V

گلدون هوشمند — نقشه سیم‌کشی ESP32 حیاط · تمام GNDها مشترک · SIM و پمپ از منبع جدا
