Artemis-98/goldon/docs/project-report/شماتیک.pdf

GND 22 | GND | 23 GND | 24 IO19 | 25 IO20 | 26 IO21 | 27 IO47 | 28 IO48 | 29 IO45 | 30 IO0 | 31 IO35 | 32 IO36 | 33 IO37 | 34 IO38 | 35 IO39 | 36 IO40 | 37 IO41 | 38 IO42 | 39 IO2 | 40 IO1 | 41 RX | 42 TX | 43 GND | 44 *

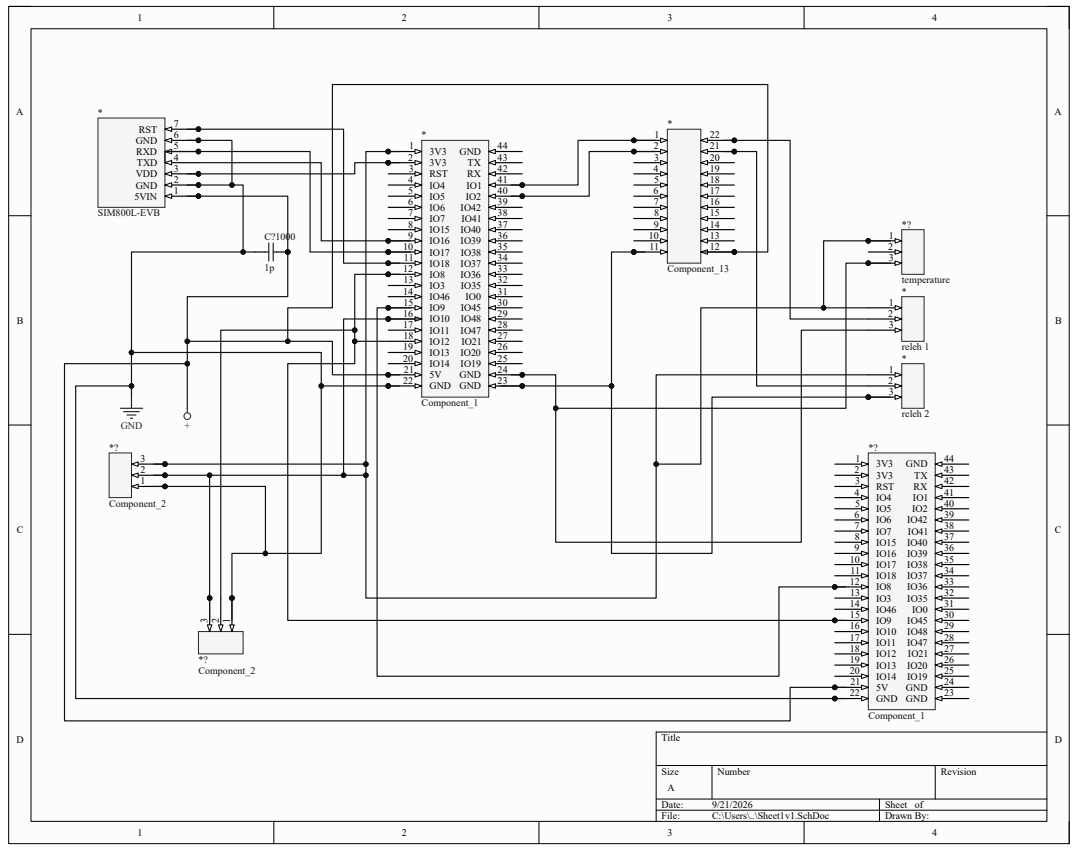
[picture p23: page 1]
Title; Size; Number; Revision A; Date:; Sheet of; File:; C:\Users\..\Sheet1v1.SchDoc; Drawn By:; RST; Component_1; 5VIN; GND; VDD; TXD; RXD; SIM800L-EVB; Component_13; releh 1; releh 2 321; *? Component_2; Component_2; temperature; GND 22; 23 GND; 43 GND
